masonk06/robot-dog-assembly/CURRENT-PCB.md

# Current PCB for the 1 oz cost-reduction request

Use **revision_one_oz**, revision C. Its native project is
`revision_one_oz/Luca_power_distribution_four_leg.kicad_pro`.

Its updated order package uses **1 oz copper on both sides** and **top-side-only
component placement**. The circuit and 5 A leg fuses are retained, with relocated
parts and new routing. Do not reuse revision B's Gerbers, BOM/CPL or assembly
drawings when requesting 1 oz. Re-upload the complete revision C set at JLCPCB.

Revision B remains preserved in `revision_four_leg` and requires 2 oz copper.
Both revisions are validation prototypes, with powered-use verification open.
