masonk06/robot-dog-assembly/reports/sim2real/20261026-212718.csv

time_s | servo_id | target_ticks | measured_ticks | error_ticks | temperature_c
0.0 | 8 | 1677 | 1677 | 0 | 31
0.0 | 9 | 1572 | 1577 | 5 | 32
0.0470000000022992 | 8 | 1677 | 1677 | 0 | 31
0.0470000000022992 | 9 | 1572 | 1576 | 4 | 32
0.09400000000096043 | 8 | 1677 | 1677 | 0 | 31
0.09400000000096043 | 9 | 1572 | 1576 | 4 | 32
0.125 | 8 | 1677 | 1677 | 0 | 31
0.125 | 9 | 1572 | 1576 | 4 | 32
0.1720000000022992 | 8 | 1677 | 1677 | 0 | 31
0.1720000000022992 | 9 | 1572 | 1574 | 2 | 32
0.20300000000133878 | 8 | 1677 | 1677 | 0 | 31
0.20300000000133878 | 9 | 1572 | 1574 | 2 | 32
0.2649999999994179 | 8 | 1677 | 1677 | 0 | 31
0.2649999999994179 | 9 | 1572 | 1574 | 2 | 32
0.2970000000022992 | 8 | 1677 | 1677 | 0 | 31
0.2970000000022992 | 9 | 1572 | 1574 | 2 | 32
0.3280000000013388 | 8 | 1678 | 1677 | -1 | 31
0.3280000000013388 | 9 | 1572 | 1574 | 2 | 32
0.375 | 8 | 1678 | 1677 | -1 | 31
0.375 | 9 | 1572 | 1574 | 2 | 32
0.40600000000267755 | 8 | 1678 | 1677 | -1 | 31
0.40600000000267755 | 9 | 1572 | 1574 | 2 | 32
0.4530000000013388 | 8 | 1678 | 1677 | -1 | 31
0.4530000000013388 | 9 | 1572 | 1574 | 2 | 32
0.48400000000037835 | 8 | 1678 | 1677 | -1 | 31
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
