masonk06/robot-dog-assembly/reports/sim2real/20261026-213629.csv

time_s | servo_id | target_ticks | measured_ticks | error_ticks | temperature_c
0.0 | 8 | 1677 | 1678 | 1 | 31
0.0 | 9 | 1572 | 1572 | 0 | 32
0.0790000000015425 | 8 | 1677 | 1678 | 1 | 31
0.0790000000015425 | 9 | 1572 | 1572 | 0 | 32
0.125 | 8 | 1677 | 1678 | 1 | 31
0.125 | 9 | 1572 | 1572 | 0 | 32
0.18800000000192085 | 8 | 1677 | 1678 | 1 | 31
0.18800000000192085 | 9 | 1572 | 1572 | 0 | 32
0.25 | 8 | 1677 | 1678 | 1 | 31
0.25 | 9 | 1572 | 1572 | 0 | 31
0.31300000000192085 | 8 | 1677 | 1678 | 1 | 31
0.31300000000192085 | 9 | 1572 | 1572 | 0 | 32
0.375 | 8 | 1678 | 1678 | 0 | 31
0.375 | 9 | 1572 | 1572 | 0 | 32
0.4220000000022992 | 8 | 1678 | 1678 | 0 | 31
0.4220000000022992 | 9 | 1572 | 1572 | 0 | 32
0.4850000000005821 | 8 | 1678 | 1678 | 0 | 31
0.4850000000005821 | 9 | 1572 | 1572 | 0 | 32
0.5470000000022992 | 8 | 1678 | 1678 | 0 | 31
0.5630000000019209 | 9 | 1572 | 1572 | 0 | 31
0.5940000000009604 | 8 | 1678 | 1678 | 0 | 31
0.5940000000009604 | 9 | 1573 | 1572 | -1 | 32
0.6880000000019209 | 8 | 1679 | 1678 | -1 | 31
0.6880000000019209 | 9 | 1573 | 1572 | -1 | 32
0.7350000000005821 | 8 | 1679 | 1678 | -1 | 31
0.7350000000005821 | 9 | 1573 | 1572 | -1 | 32
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
