masonk06/robot-dog-assembly/reports/sim2real/20261026-220232.csv

time_s | servo_id | target_ticks | measured_ticks | error_ticks | temperature_c
0.0 | 8 | 1677 | 1680 | 3 | 32
0.0 | 9 | 1572 | 1573 | 1 | 32
0.046999999998661224 | 8 | 1677 | 1680 | 3 | 32
0.046999999998661224 | 9 | 1572 | 1573 | 1 | 32
0.10899999999674037 | 8 | 1677 | 1680 | 3 | 32
0.10899999999674037 | 9 | 1572 | 1573 | 1 | 32
0.13999999999941792 | 8 | 1677 | 1680 | 3 | 32
0.1559999999954016 | 9 | 1572 | 1573 | 1 | 32
0.18699999999807915 | 8 | 1677 | 1680 | 3 | 32
0.18699999999807915 | 9 | 1572 | 1573 | 1 | 32
0.2649999999994179 | 8 | 1677 | 1680 | 3 | 32
0.2649999999994179 | 9 | 1572 | 1573 | 1 | 32
0.2969999999986612 | 8 | 1677 | 1680 | 3 | 32
0.2969999999986612 | 9 | 1572 | 1573 | 1 | 32
0.35899999999674037 | 8 | 1677 | 1680 | 3 | 32
0.35899999999674037 | 9 | 1572 | 1573 | 1 | 32
0.4059999999954016 | 8 | 1677 | 1680 | 3 | 32
0.4059999999954016 | 9 | 1572 | 1573 | 1 | 32
0.4530000000013388 | 8 | 1678 | 1680 | 2 | 32
0.4530000000013388 | 9 | 1572 | 1573 | 1 | 32
0.5 | 8 | 1678 | 1680 | 2 | 32
0.5 | 9 | 1572 | 1573 | 1 | 32
0.5469999999986612 | 8 | 1678 | 1680 | 2 | 32
0.5469999999986612 | 9 | 1572 | 1573 | 1 | 32
0.6089999999967404 | 8 | 1678 | 1680 | 2 | 32
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
