masonk06/robot-dog-assembly/hardware/replay_plans/rear-left-3deg/rear-left-small-preview.csv

time_s | hip_model_deg | knee_model_deg | hip_id8_ticks | knee_id9_ticks
0.000000000000000000e+00 | 0.000000000000000000e+00 | -0.000000000000000000e+00 | 1.677000000000000000e+03 | 1.572000000000000000e+03
4.000000000000000083e-02 | 8.892123004210696503e-04 | -3.638273935078280459e-04 | 1.677000000000000000e+03 | 1.572000000000000000e+03
8.000000000000000167e-02 | 3.496563621994713822e-03 | -1.430643310064679550e-03 | 1.677000000000000000e+03 | 1.572000000000000000e+03
1.199999999999999956e-01 | 7.731625595186588165e-03 | -3.163448353720606319e-03 | 1.677000000000000000e+03 | 1.572000000000000000e+03
1.600000000000000033e-01 | 1.350396985046234226e-02 | -5.525243128525658860e-03 | 1.677000000000000000e+03 | 1.572000000000000000e+03
2.000000000000000111e-01 | 2.072316801828763197e-02 | -8.479028238529888115e-03 | 1.677000000000000000e+03 | 1.572000000000000000e+03
2.399999999999999911e-01 | 2.929879172912812357e-02 | -1.198780428778335218e-02 | 1.677000000000000000e+03 | 1.572000000000000000e+03
2.800000000000000266e-01 | 3.914041261344945039e-02 | -1.601457188033609050e-02 | 1.677000000000000000e+03 | 1.572000000000000000e+03
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
