masonk06/robot-dog-assembly/hardware/replay_plans/rear-left-5deg/rear-left-small-preview.csv

time_s | hip_model_deg | knee_model_deg | hip_id8_ticks | knee_id9_ticks
0.000000000000000000e+00 | 0.000000000000000000e+00 | -0.000000000000000000e+00 | 1.677000000000000000e+03 | 1.572000000000000000e+03
5.999999999999999778e-02 | 1.482020281938936732e-03 | -6.063784124675527078e-04 | 1.677000000000000000e+03 | 1.572000000000000000e+03
1.199999999999999956e-01 | 5.827605176437851767e-03 | -2.384403249024952785e-03 | 1.677000000000000000e+03 | 1.572000000000000000e+03
1.799999999999999933e-01 | 1.288604075651990713e-02 | -5.272408908404313706e-03 | 1.677000000000000000e+03 | 1.572000000000000000e+03
2.399999999999999911e-01 | 2.250661309520825618e-02 | -9.208729789337748509e-03 | 1.677000000000000000e+03 | 1.572000000000000000e+03
2.999999999999999889e-01 | 3.453860826552605789e-02 | -1.413170029055736861e-02 | 1.677000000000000000e+03 | 1.572000000000000000e+03
3.599999999999999867e-01 | 4.883131234049649383e-02 | -1.997965481079529843e-02 | 1.678000000000000000e+03 | 1.572000000000000000e+03
4.199999999999999845e-01 | 6.523401139314267960e-02 | -2.669092774878363203e-02 | 1.678000000000000000e+03 | 1.572000000000000000e+03
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
