masonk06/robot-dog-assembly/hardware/replay_plans/rear-left-full-46s/rear-left-small-preview.csv

time_s | hip_model_deg | knee_model_deg | hip_id8_ticks | knee_id9_ticks
0.000000000000000000e+00 | 0.000000000000000000e+00 | -0.000000000000000000e+00 | 1.677000000000000000e+03 | 1.572000000000000000e+03
4.999999999999999584e-02 | 2.653465253920772246e-03 | -1.085681972209229153e-03 | 1.677000000000000000e+03 | 1.572000000000000000e+03
9.999999999999999167e-02 | 5.306930507841544492e-03 | -2.171363944418458307e-03 | 1.677000000000000000e+03 | 1.572000000000000000e+03
1.499999999999999944e-01 | 7.960395761762316738e-03 | -3.257045916627687460e-03 | 1.677000000000000000e+03 | 1.572000000000000000e+03
1.999999999999999833e-01 | 1.061386101568308898e-02 | -4.342727888836916614e-03 | 1.677000000000000000e+03 | 1.572000000000000000e+03
2.499999999999999722e-01 | 1.839436082802704472e-02 | -7.526168248026689211e-03 | 1.677000000000000000e+03 | 1.572000000000000000e+03
2.999999999999999889e-01 | 2.617486064037100740e-02 | -1.070960860721646354e-02 | 1.677000000000000000e+03 | 1.572000000000000000e+03
3.499999999999999778e-01 | 3.395536045271496661e-02 | -1.389304896640623788e-02 | 1.677000000000000000e+03 | 1.572000000000000000e+03
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
