masonk06/robot-dog-assembly/boot_fit.png

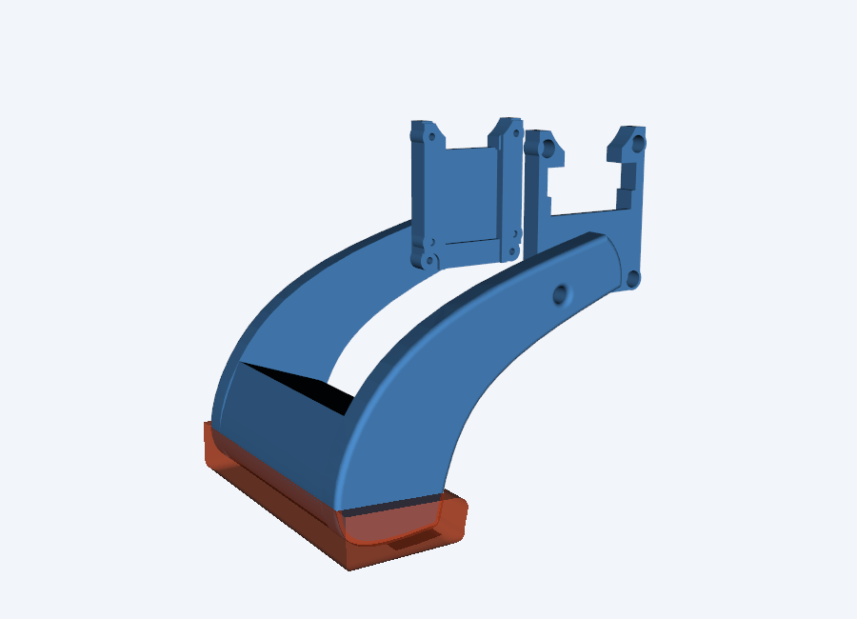
boot_fit.png
