masonk06/robot-dog-assembly/cad/frame_v7/Frame_V7_layout.png

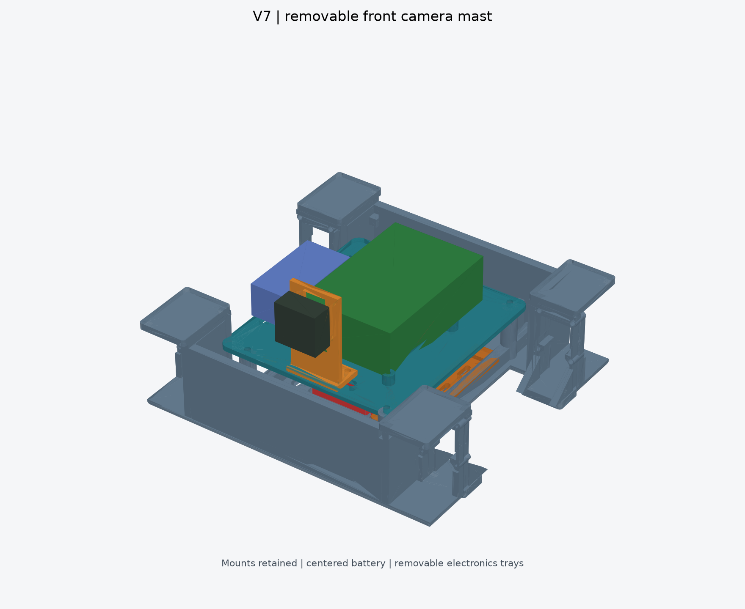
cad/frame_v7/Frame_V7_layout.png
