masonk06/robot-dog-assembly/cad/front_rear_leg_variants/Front_Leg_Orientation_Reference.png

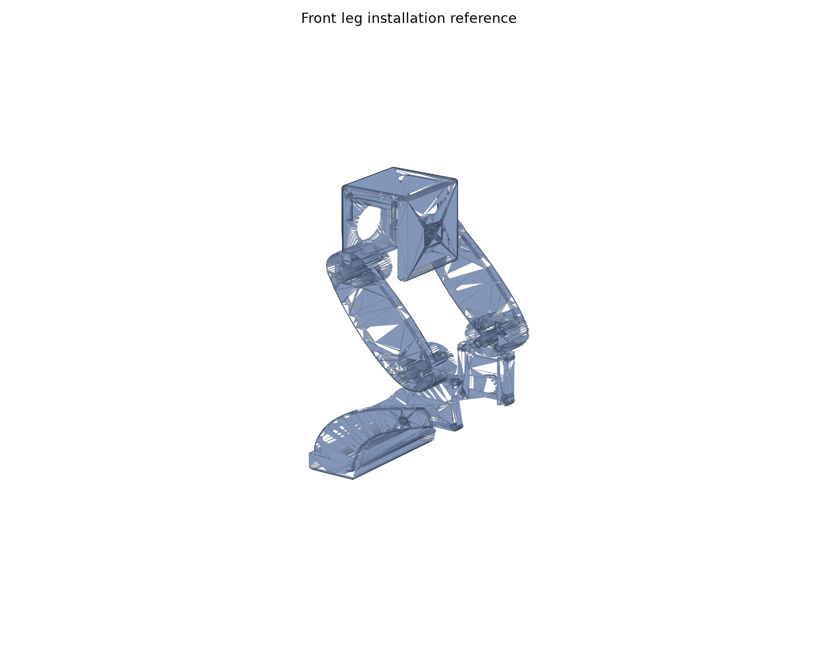
cad/front_rear_leg_variants/Front_Leg_Orientation_Reference.png
