masonk06/robot-dog-assembly/detail.png

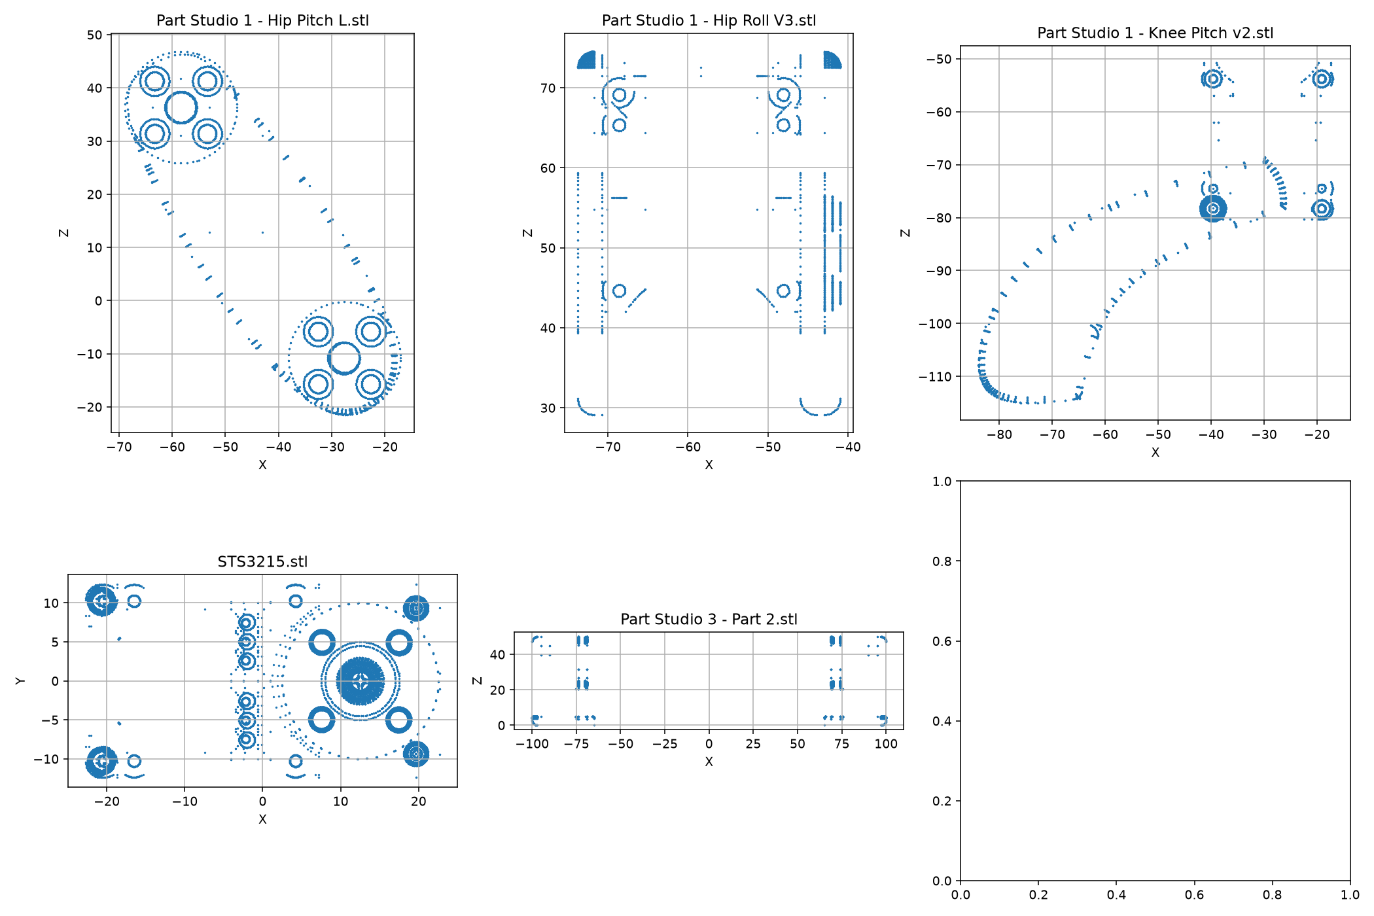
detail.png
