masonk06/robot-dog-assembly/reports/sim2real/simulation-neutral-reference.png

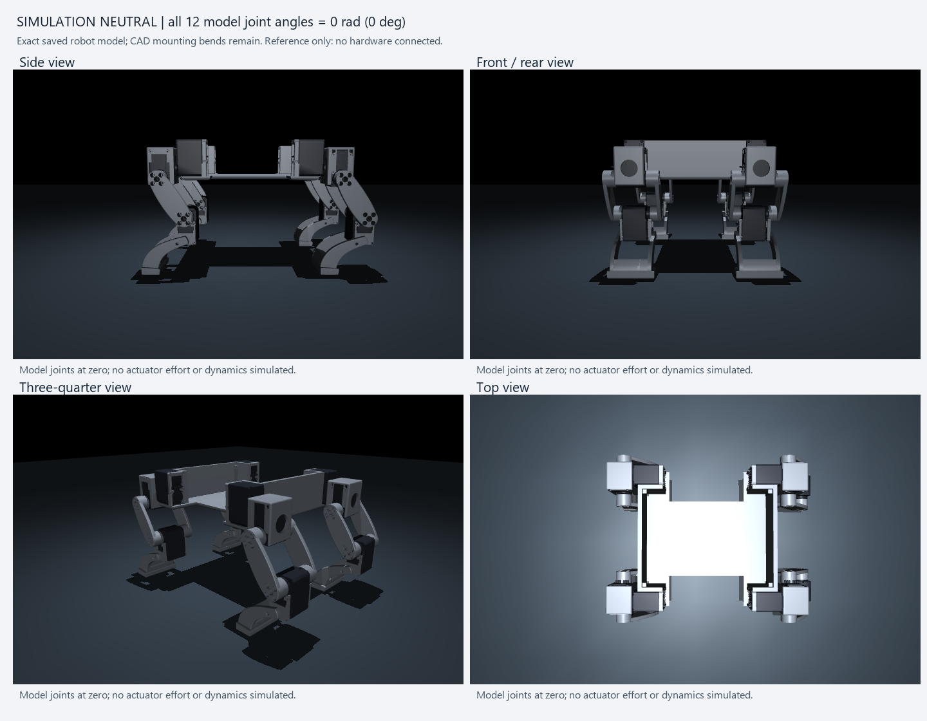
reports/sim2real/simulation-neutral-reference.png
