masonk06/robot-dog-assembly/revision_four_leg/layout-preview.png

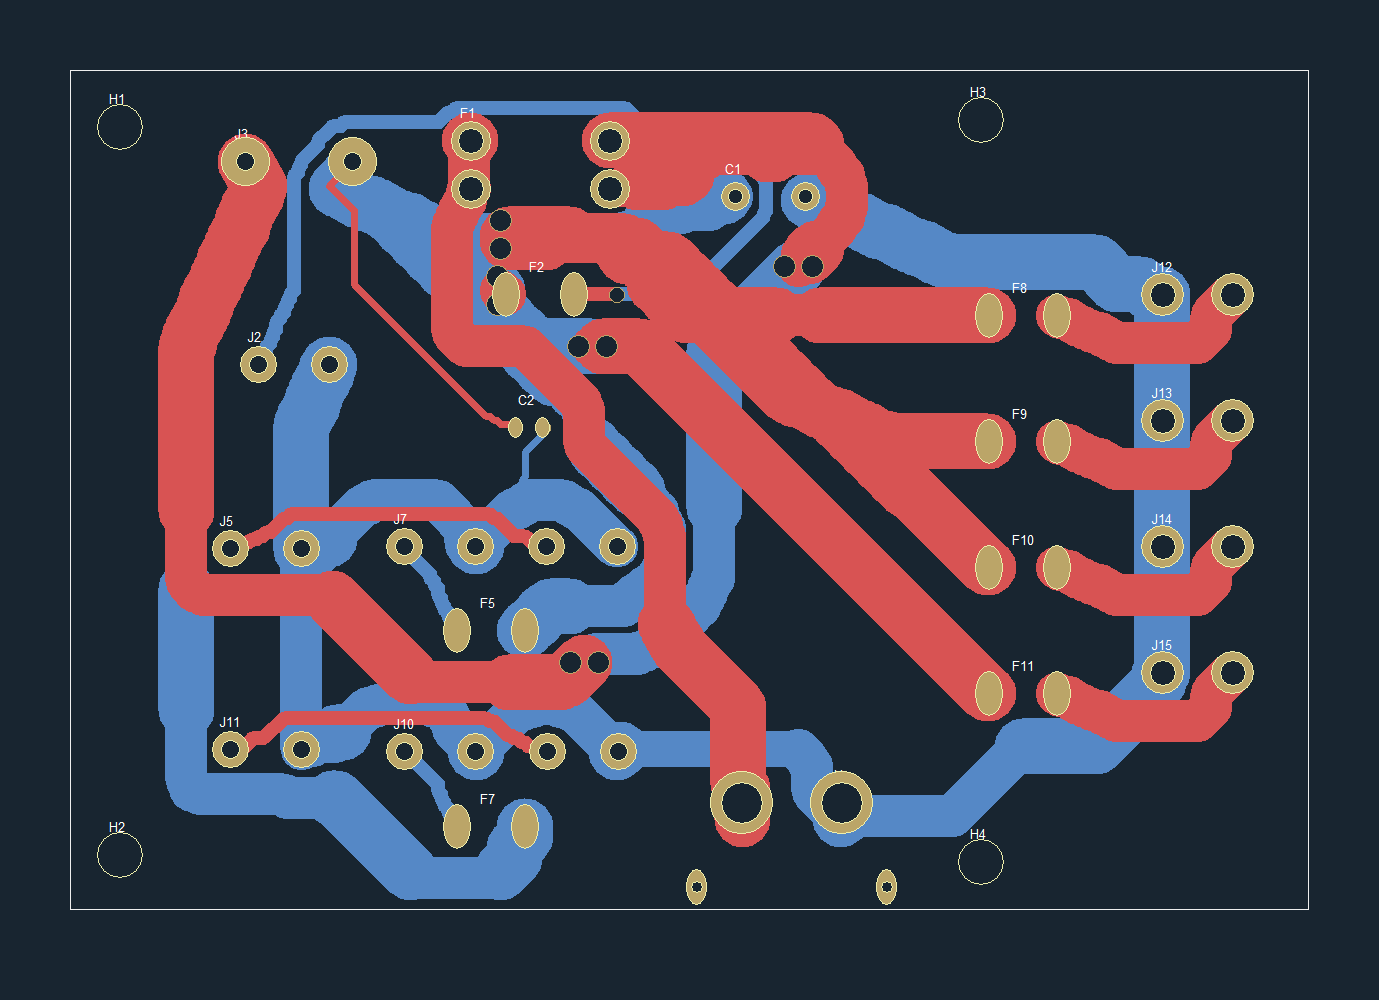
revision_four_leg/layout-preview.png
