masonk06/robot-dog-assembly/revision_four_leg/manufacturer_references/Bel_0680H_mechanical.png

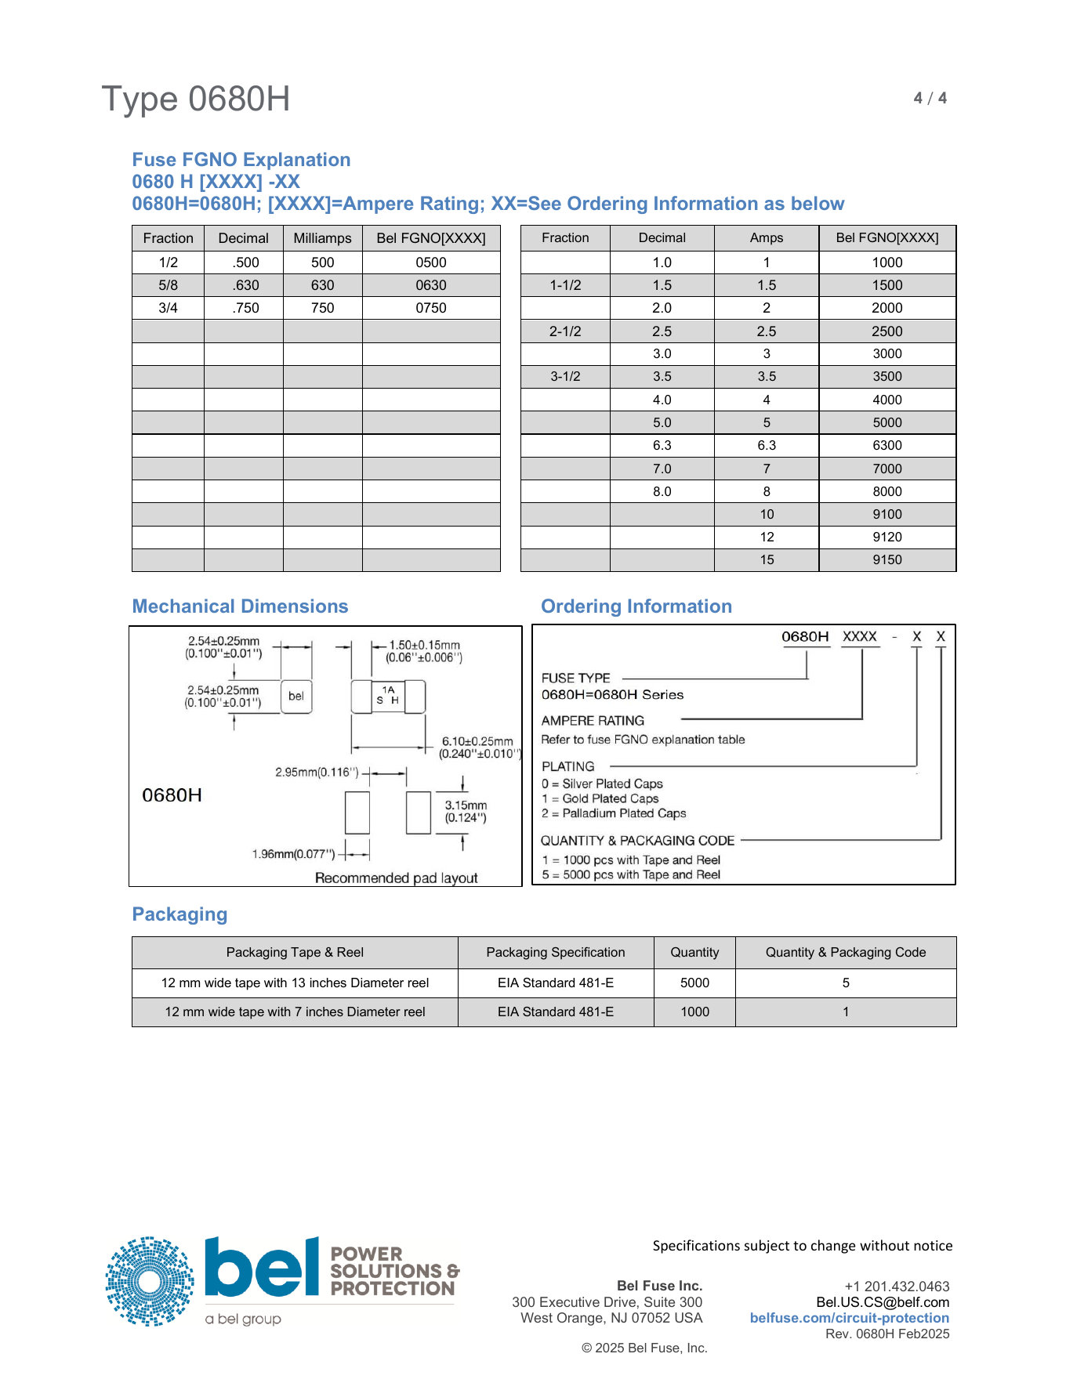
revision_four_leg/manufacturer_references/Bel_0680H_mechanical.png
