masonk06/robot-dog-assembly/revision_one_oz/COPPER-FINAL-1.png

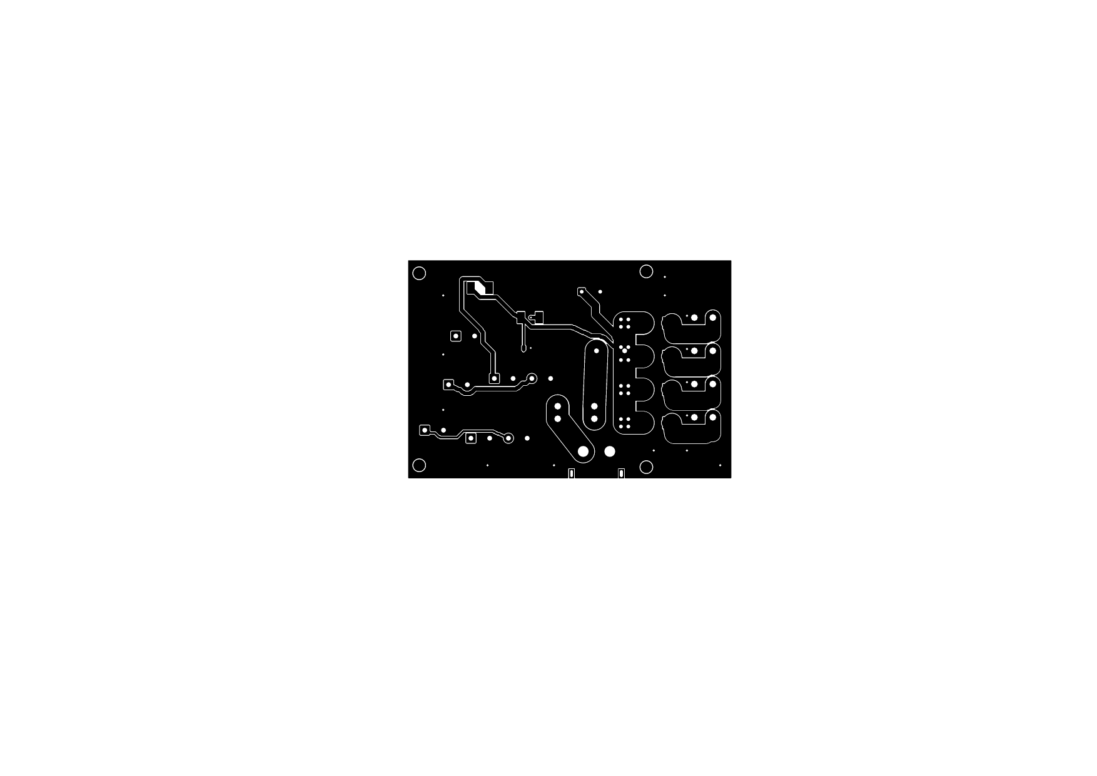
revision_one_oz/COPPER-FINAL-1.png
