masonk06/robot-dog-assembly/roll_detail.png

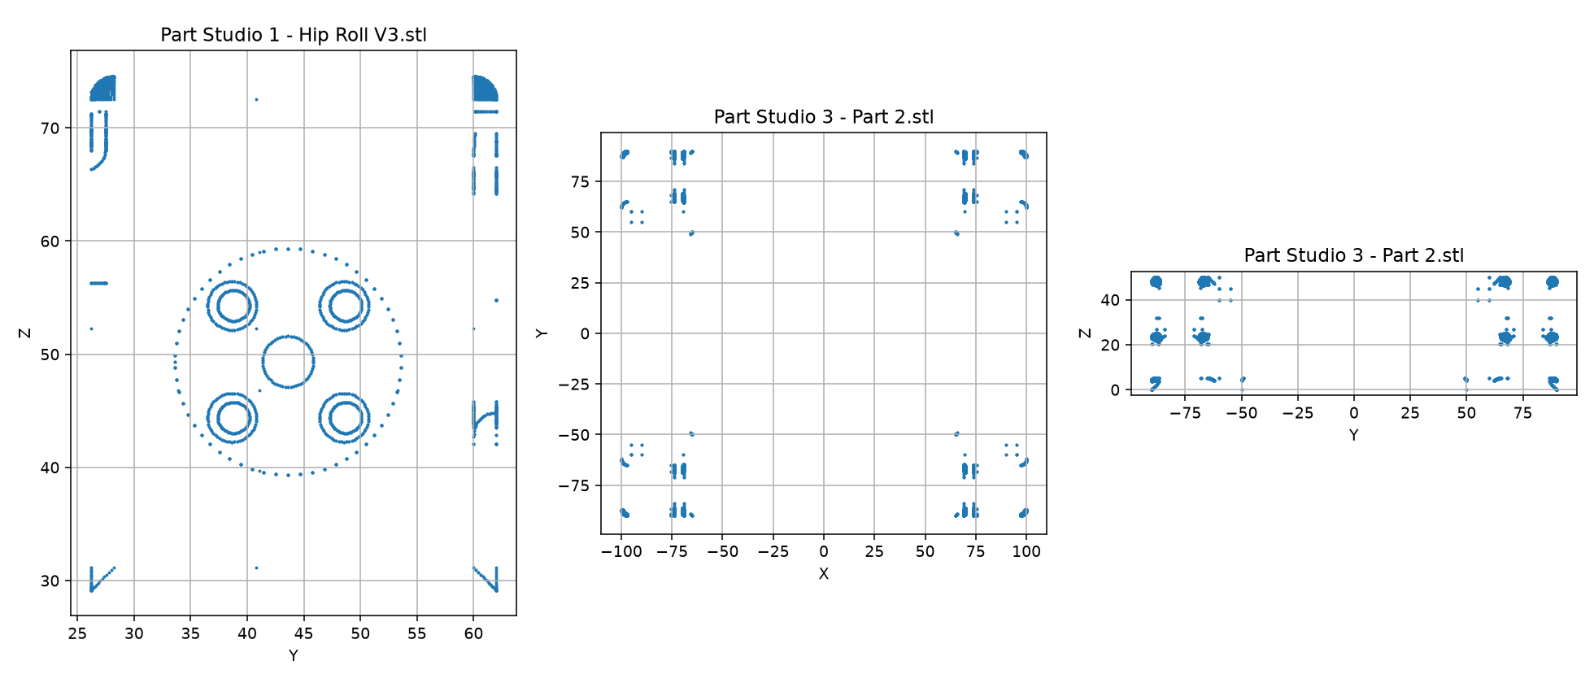
roll_detail.png
