masonk06/robot-dog-assembly/runs/com-dynamics-study/comparison.png

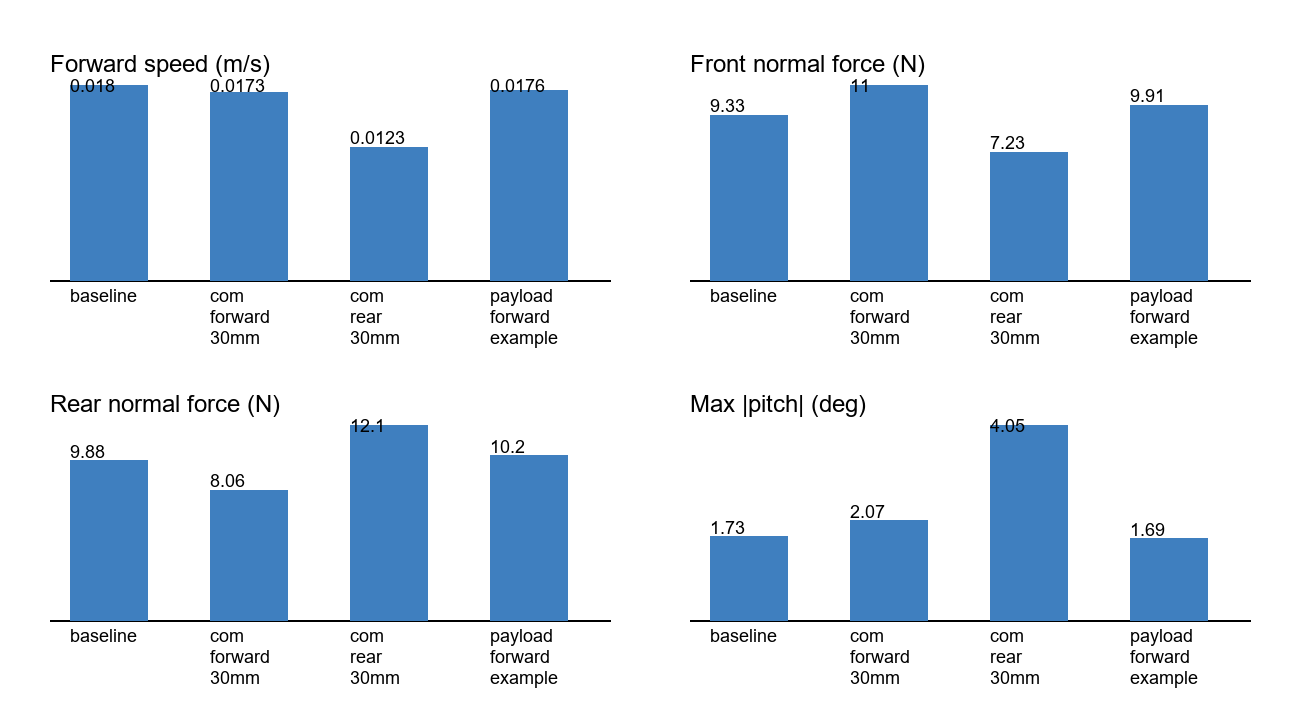
runs/com-dynamics-study/comparison.png
