masonk06/robot-dog-assembly/cad/parts.png

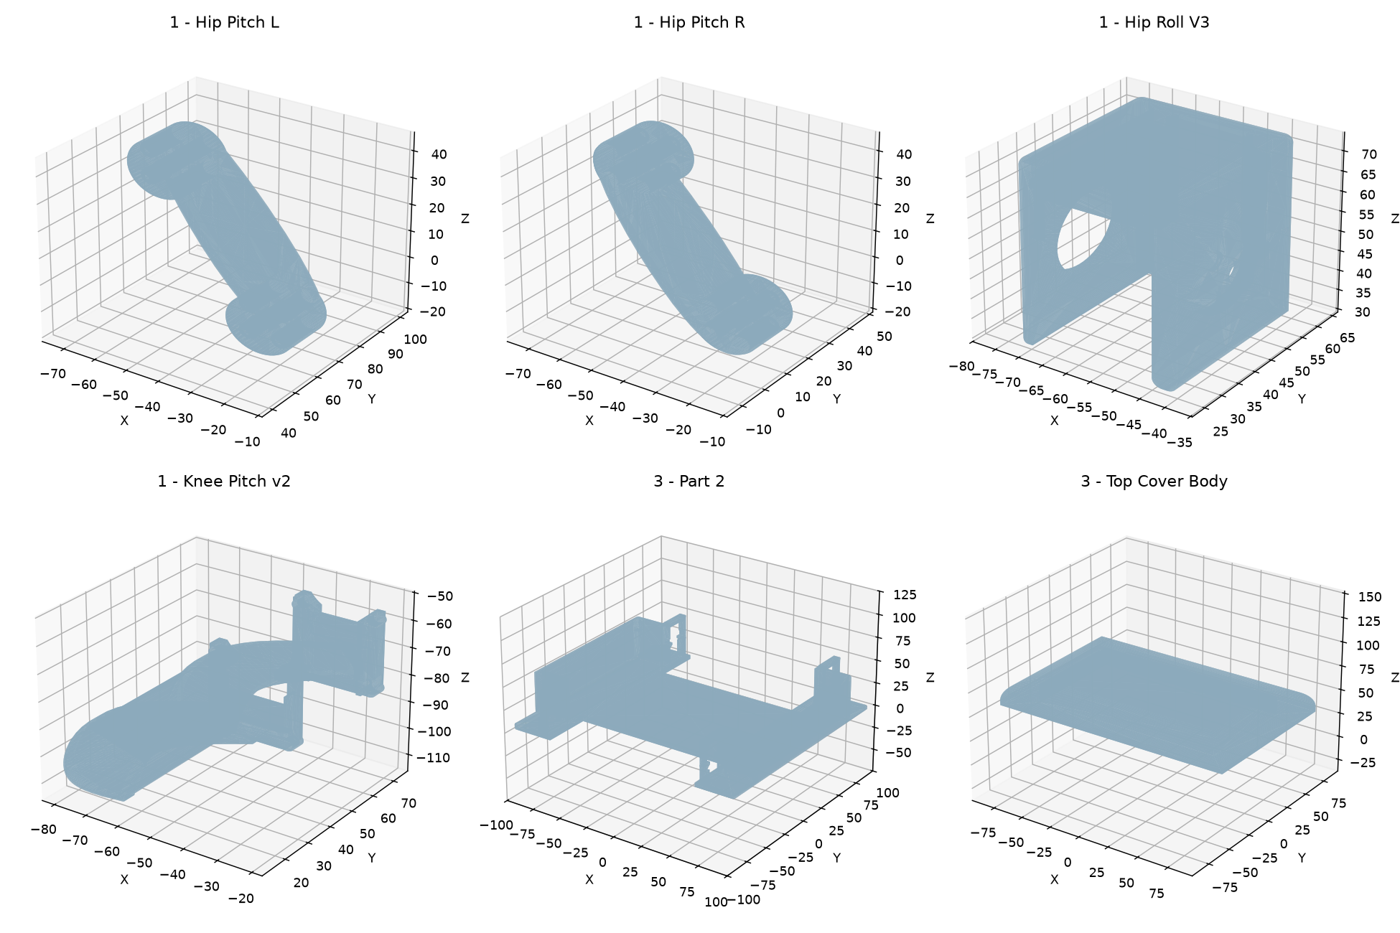
cad/parts.png
