masonk06/robot-dog-assembly/cad/frame_v7/RoboDog_V7_Equipment_Layout.step

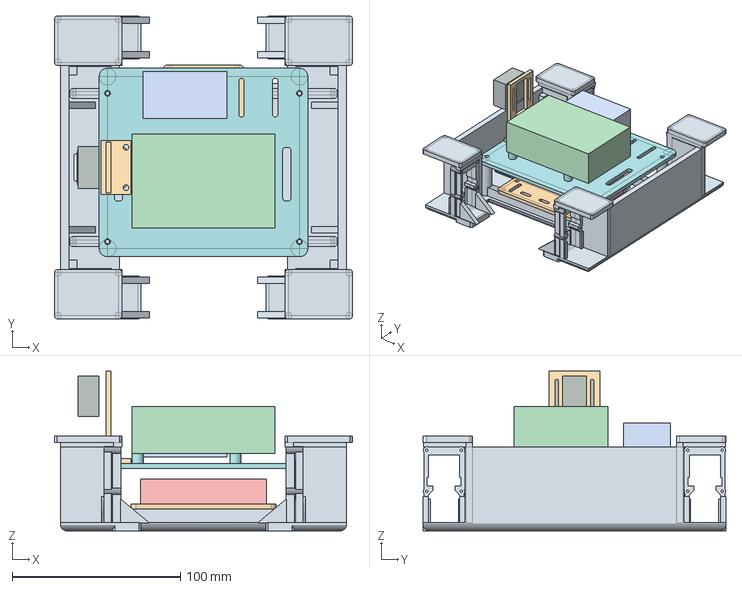
[picture p15: CAD file, 2026-11-04]
cad/frame_v7/RoboDog_V7_Equipment_Layout.step
177.0 x 179.8 x 95.0 mm
