masonk06/robot-dog-assembly/cad/front_rear_leg_variants/Front_Leg_Orientation_Reference.step

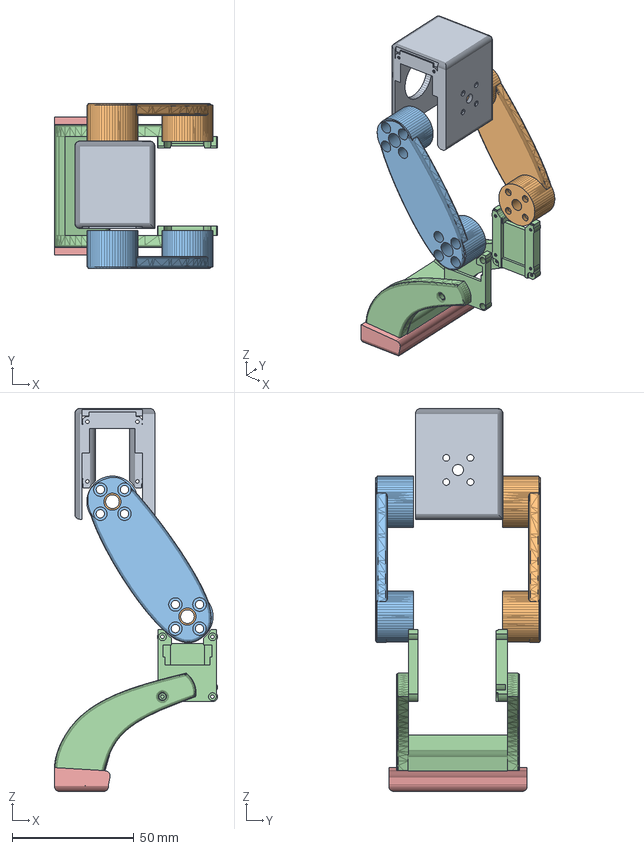
[picture p16: CAD file, 2026-10-26]
cad/front_rear_leg_variants/Front_Leg_Orientation_Reference.step
66.9 x 67.6 x 157.0 mm
