masonk06/robot-dog-assembly/cad/positioned_parts/rear_left_hip_roll.stl

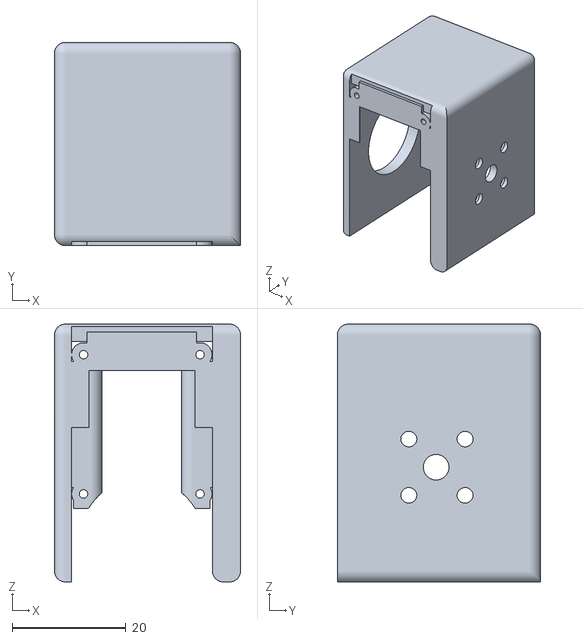
[picture p17: CAD file, 2026-10-26]
cad/positioned_parts/rear_left_hip_roll.stl
32.8 x 35.8 x 45.4
