masonk06/robot-dog-assembly/cad/revision_sources/STS3215_case_fixed.step

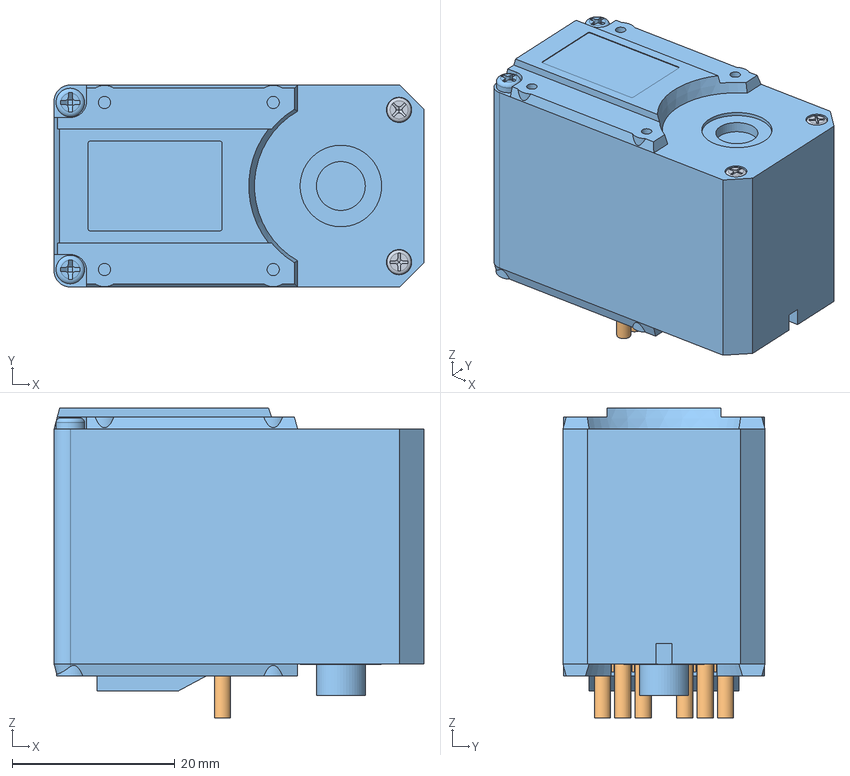
[picture p18: CAD file, 2026-10-26]
cad/revision_sources/STS3215_case_fixed.step
45.4 x 24.8 x 38.0 mm
