masonk06/robot-dog-assembly/cad/robot_dog_layout.stl

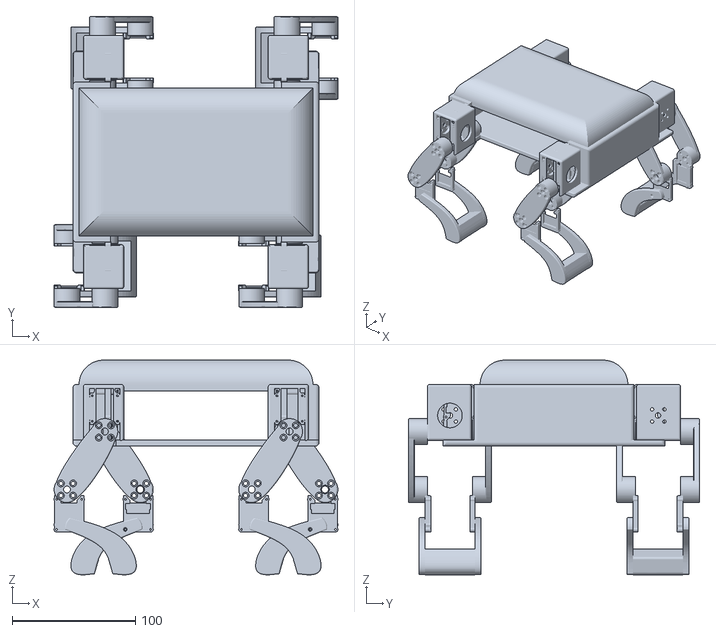
[picture p19: CAD file, 2026-10-26]
cad/robot_dog_layout.stl
230.6 x 236.6 x 174.4
