masonk06/robot-dog-assembly/cad/solid_sources/Part Studio 1 - Hip Pitch L.step

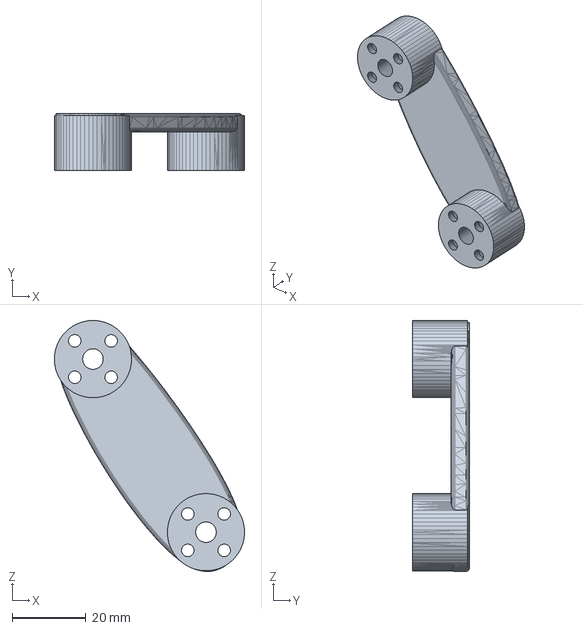
[picture p20: CAD file, 2026-10-26]
cad/solid_sources/Part Studio 1 - Hip Pitch L.step
51.7 x 15.5 x 68.3 mm
