masonk06/robot-dog-assembly/cad/source/STS3215.stl

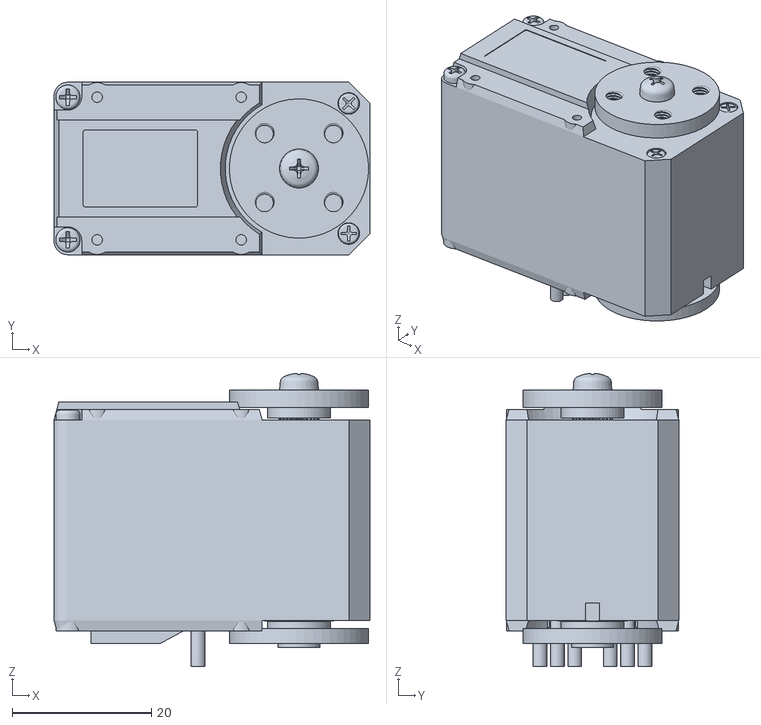
[picture p21: CAD file, 2026-10-26]
cad/source/STS3215.stl
45.4 x 24.8 x 42.1
