masonk06/robot-dog-assembly/revision_sources/boots.stl

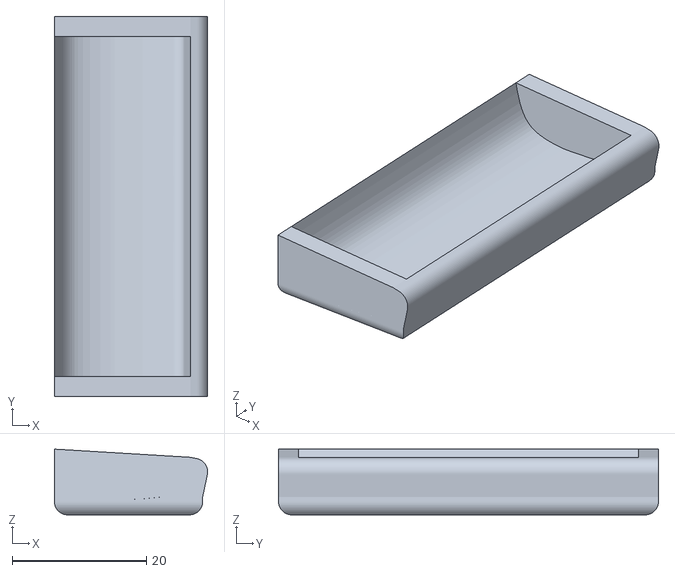
[picture p22: CAD file, 2026-10-24]
revision_sources/boots.stl
22.8 x 56.6 x 9.80
