masonk06/robot-dog-assembly/source/Part Studio 3 - Top Cover Body.stl

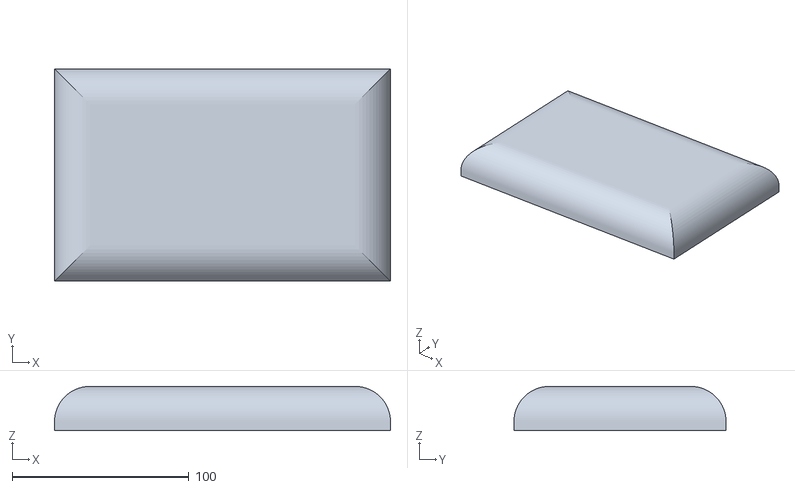
[picture p23: CAD file, 2026-10-24]
source/Part Studio 3 - Top Cover Body.stl
190.0 x 120.0 x 25.0
