masonk06/robot-dog-assembly/cad/revision_sources/FRAME V2.stl

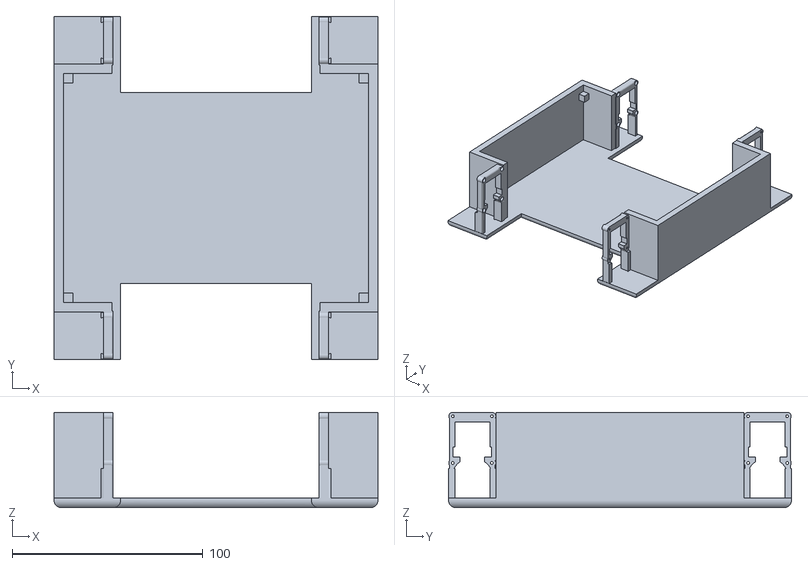
[picture p24: CAD file, 2026-10-26]
cad/revision_sources/FRAME V2.stl
170.0 x 180.0 x 50.1
