masonk06/robot-dog-assembly/positioned_parts/front_right_knee_v2.stl

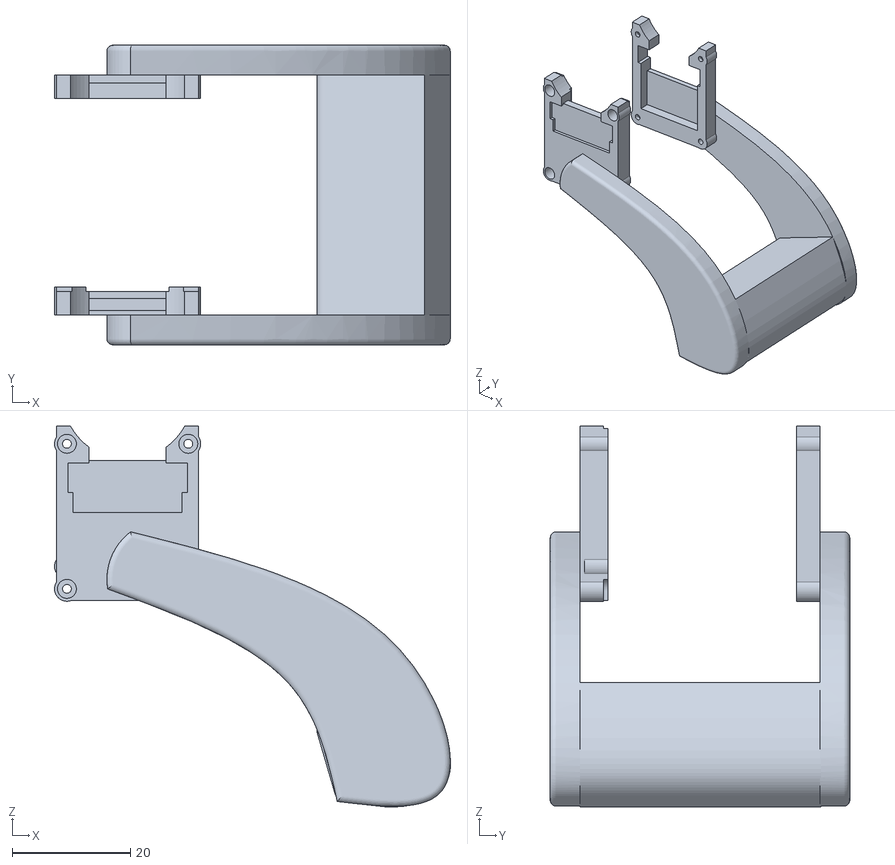
[picture p25: CAD file, 2026-10-24]
positioned_parts/front_right_knee_v2.stl
66.9 x 50.6 x 64.3
