masonk06/robot-dog-assembly/source/Part Studio 3 - Part 2.stl

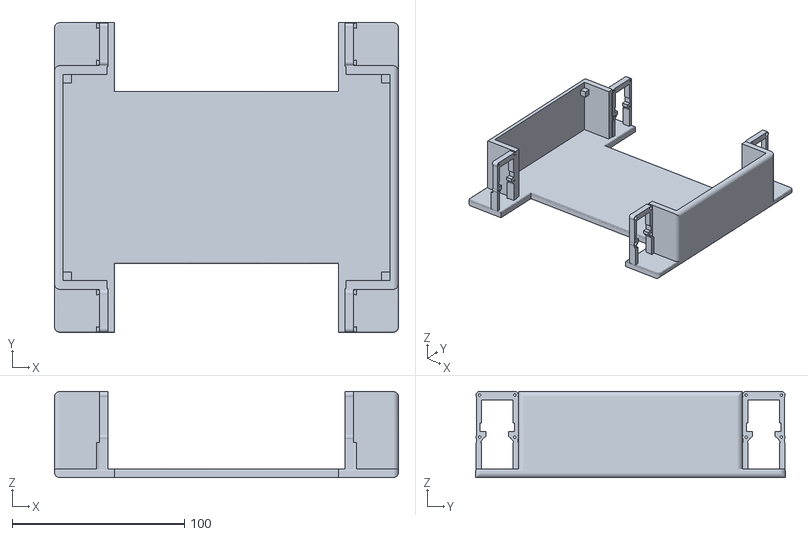
[picture p26: CAD file, 2026-10-24]
source/Part Studio 3 - Part 2.stl
200.0 x 180.0 x 50.1
