masonk06/robot-dog-assembly/cad/frame_v7/Camera_Mast.step

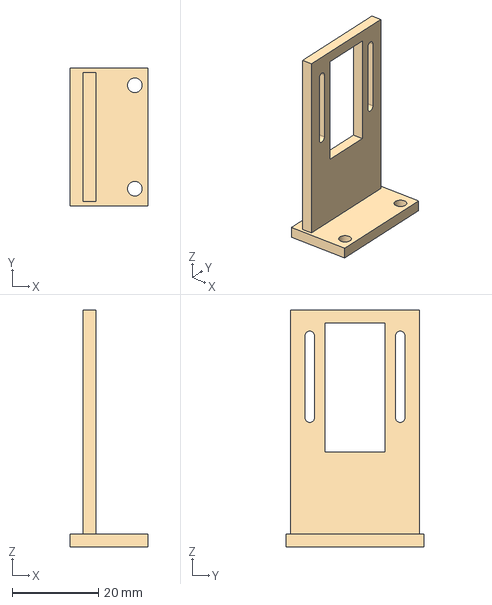
[picture p27: CAD file, 2026-11-04]
cad/frame_v7/Camera_Mast.step
18.0 x 32.0 x 55.0 mm
