masonk06/robot-dog-assembly/cad/frame_v7/Power_Distribution_Sled.step

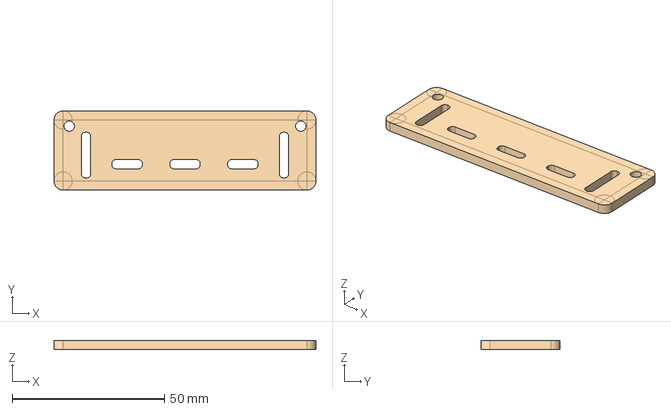
[picture p28: CAD file, 2026-11-04]
cad/frame_v7/Power_Distribution_Sled.step
86.0 x 26.0 x 3.00 mm
