masonk06/robot-dog-assembly/revision_sources/STS3215_discs_output.step

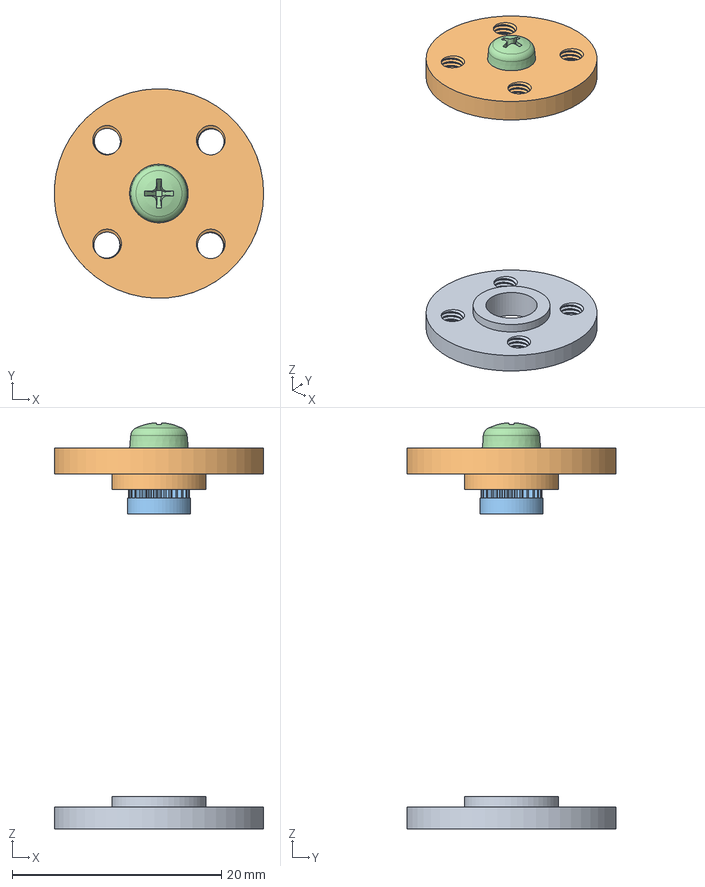
[picture p29: CAD file, 2026-10-24]
revision_sources/STS3215_discs_output.step
20.0 x 20.0 x 38.8 mm
