masonk06/robot-dog-assembly/cad/frame_v7/Pi5_Electronics_Deck.step

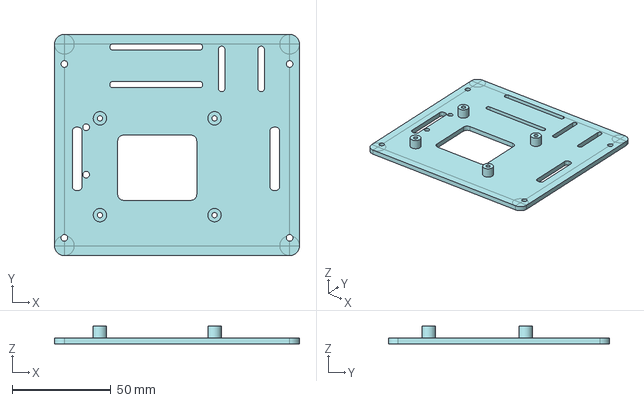
[picture p30: CAD file, 2026-11-04]
cad/frame_v7/Pi5_Electronics_Deck.step
124.0 x 112.0 x 9.00 mm
