masonk06/robot-dog-assembly/cad/frame_v7/Frame_V7.step

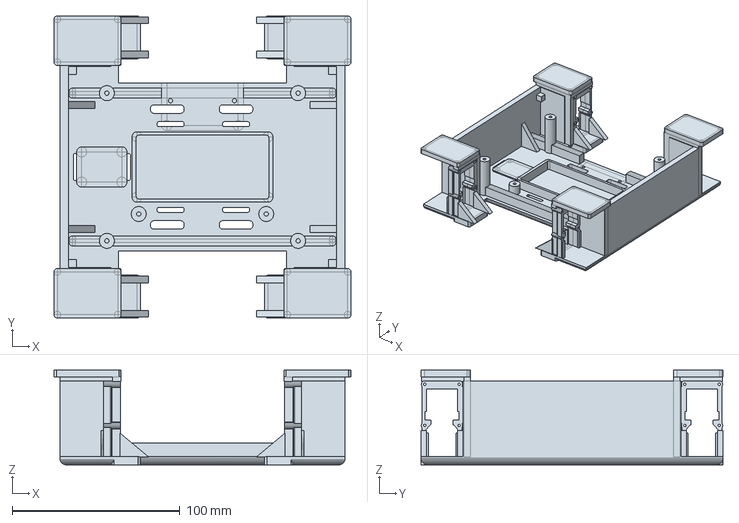
[picture p31: CAD file, 2026-11-04]
cad/frame_v7/Frame_V7.step
177.0 x 179.8 x 56.5 mm
