masonk06/robot-dog-assembly/cad/frame_v7/Waveshare_Sled.step

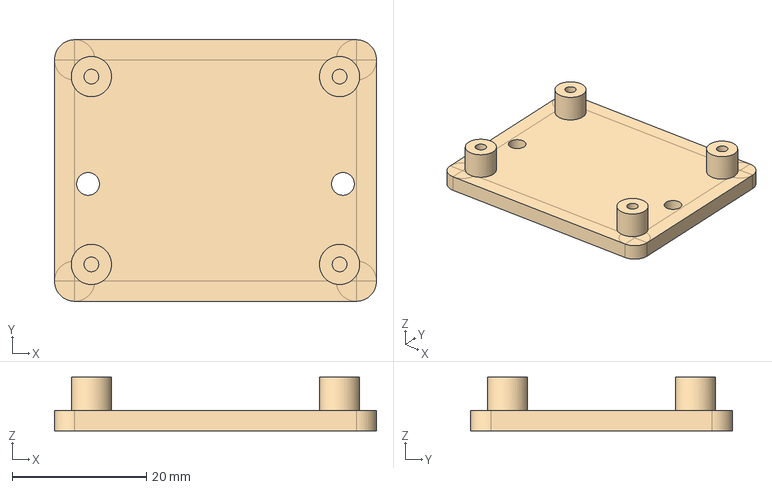
[picture p32: CAD file, 2026-11-04]
cad/frame_v7/Waveshare_Sled.step
48.0 x 39.0 x 8.00 mm
