masonk06/robot-dog-assembly/(list of files, cad)

Other CAD files:
front_rear_leg_variants/Rear_Leg_Orientation_Reference.step
mujoco_v2/assets/Part Studio 1 - Hip Pitch R.stl
positioned_parts/front_right_hip_roll.stl
solid_sources/Part Studio 1 - Hip Pitch R.step
cad/positioned_parts/rear_right_hip_pitch_R.stl
cad/solid_sources/boots.step
cad/source/Part Studio 1 - Hip Roll V3.stl
revision_sources/servo-motor_sts3215-v10.step
solid_sources/Part Studio 1 - Knee Pitch v2.step
cad/positioned_parts/rear_right_hip_pitch_L.stl
cad/revision_sources/Part Studio 1 - Knee Pitch v2.stl
positioned_parts/rear_right_hip_roll.stl
revision_sources/Part Studio 1 - Hip Pitch L.stl
solid_sources/FRAME V2.step
cad/positioned_parts/frame.stl
positioned_parts/rear_right_knee_v2.stl
solid_sources/Part Studio 1 - Hip Roll V3.step
cad/positioned_parts/front_left_hip_pitch_L.stl
positioned_parts/rear_left_hip_pitch_R.stl
cad/positioned_parts/rear_left_hip_pitch_L.stl
positioned_parts/front_left_hip_roll.stl
cad/positioned_parts/front_right_hip_pitch_L.stl
positioned_parts/front_left_hip_pitch_R.stl
cad/positioned_parts/front_left_knee_v2.stl
cad/positioned_parts/top_cover.stl
cad/positioned_parts/rear_left_knee_v2.stl
cad/positioned_parts/front_right_hip_pitch_R.stl
RoboDog.f3d
RoboDog_geometry_backup.f3d
cad/Recovered Fusion/RoboDog - FRAME V2 + boots.f3d
cad/RoboDog - Knee Housing Connections.f3d
cad/frame_v3/Frame_V3.step
cad/frame_v3/Frame_V3.stl
cad/frame_v3/Jetson_Tray.step
cad/frame_v3/Jetson_Tray.stl
cad/frame_v3/RoboDog_Frame_V3_Assembly.step
cad/frame_v3/RoboDog_Frame_V3_Layout_Reference.step
cad/frame_v3/Waveshare_Sled.step
cad/frame_v3/Waveshare_Sled.stl
cad/frame_v4/Frame_V4_Reinforced.step
cad/frame_v4/Frame_V4_Reinforced.stl
cad/frame_v4/RoboDog_Frame_V4_Assembly.step
cad/frame_v5/Frame_V5_Servo_Canopies.step
cad/frame_v5/Frame_V5_Servo_Canopies.stl
cad/frame_v5/RoboDog_Frame_V5_Assembly.step
cad/frame_v6/Frame_V6.step
cad/frame_v6/Frame_V6.stl
cad/frame_v6/Pi5_Electronics_Deck.step
cad/frame_v6/Pi5_Electronics_Deck.stl
cad/frame_v6/Power_Distribution_Sled.step
cad/frame_v6/Power_Distribution_Sled.stl
cad/frame_v6/Regulator_Spacer.step
cad/frame_v6/Regulator_Spacer.stl
cad/frame_v6/RoboDog_Frame_V6_Assembly.step
cad/frame_v6/RoboDog_Frame_V6_Packaging_Reference.step
cad/frame_v6/RoboDog_V6_Complete.step
cad/frame_v6/RoboDog_V6_Equipment_Layout.step
cad/frame_v6/Waveshare_Sled.step
cad/frame_v6/Waveshare_Sled.stl
cad/frame_v7/Camera_Mast.stl
cad/frame_v7/Frame_V7.stl
cad/frame_v7/Pi5_Electronics_Deck.stl
cad/frame_v7/Power_Distribution_Sled.stl
cad/front_rear_leg_variants/Front_Leg_Orientation_Reference.stl
cad/front_rear_leg_variants/Rear_Leg_Orientation_Reference.stl
cad/robot_dog_layout.obj
