masonk06/robot-dog-assembly/assembly_preview.png

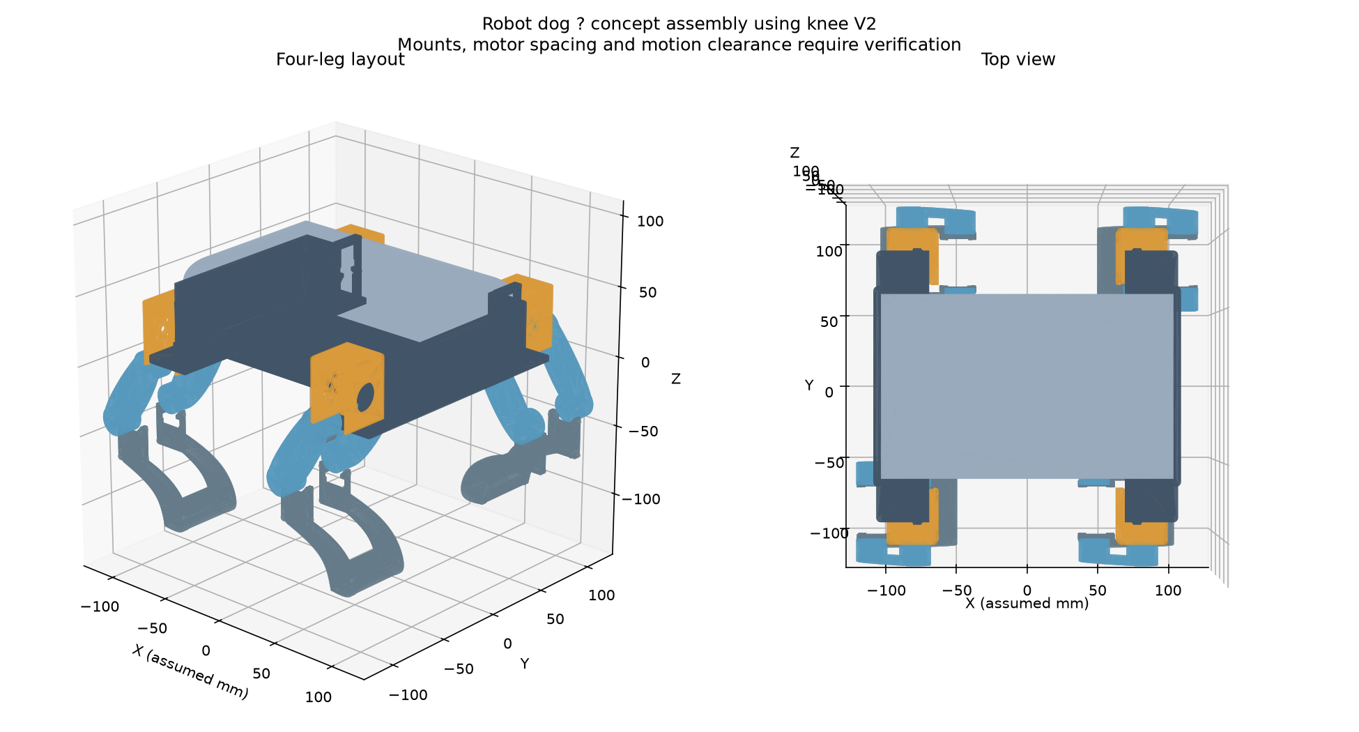
assembly_preview.png
