masonk06/robot-dog-assembly/manufacturing/layout-preview.png

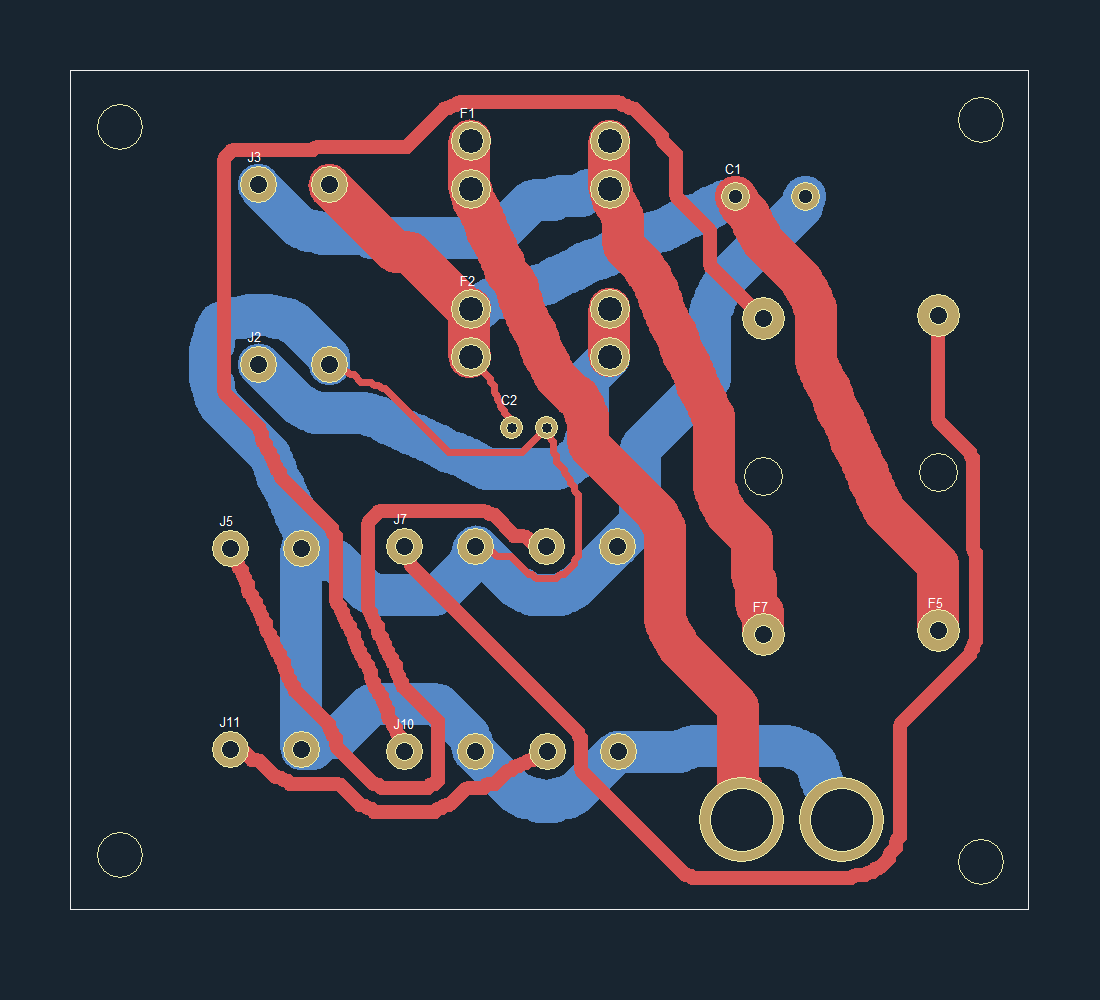
manufacturing/layout-preview.png
