masonk06/robot-dog-assembly/revision_four_leg/jlcpcb_pcba_revB/assembly/ASSEMBLY_BOTTOM.png

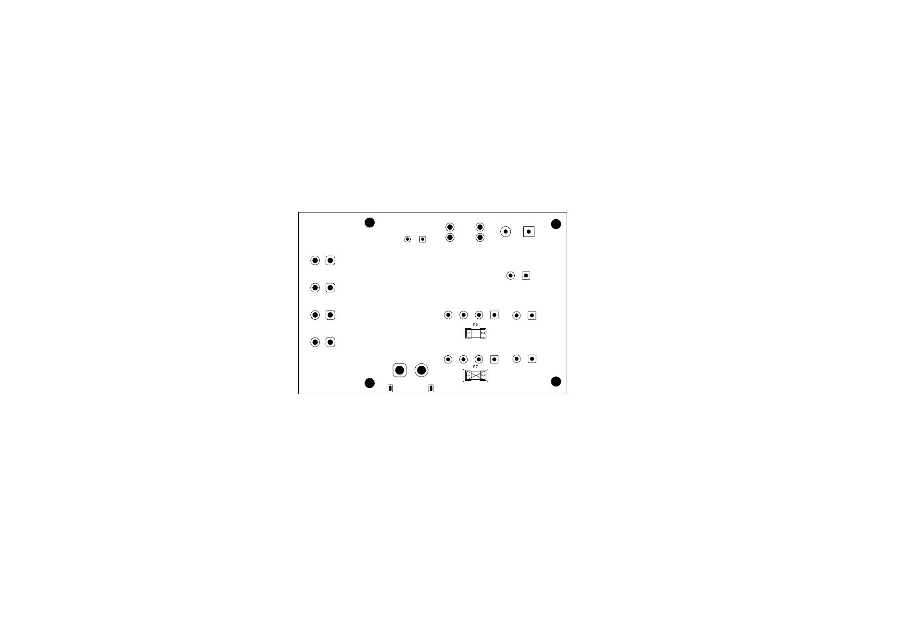
revision_four_leg/jlcpcb_pcba_revB/assembly/ASSEMBLY_BOTTOM.png
