masonk06/robot-dog-assembly/revision_four_leg/jlcpcb_pcba_revB/manufacturer_references/Phoenix_1868076_plan.jpg

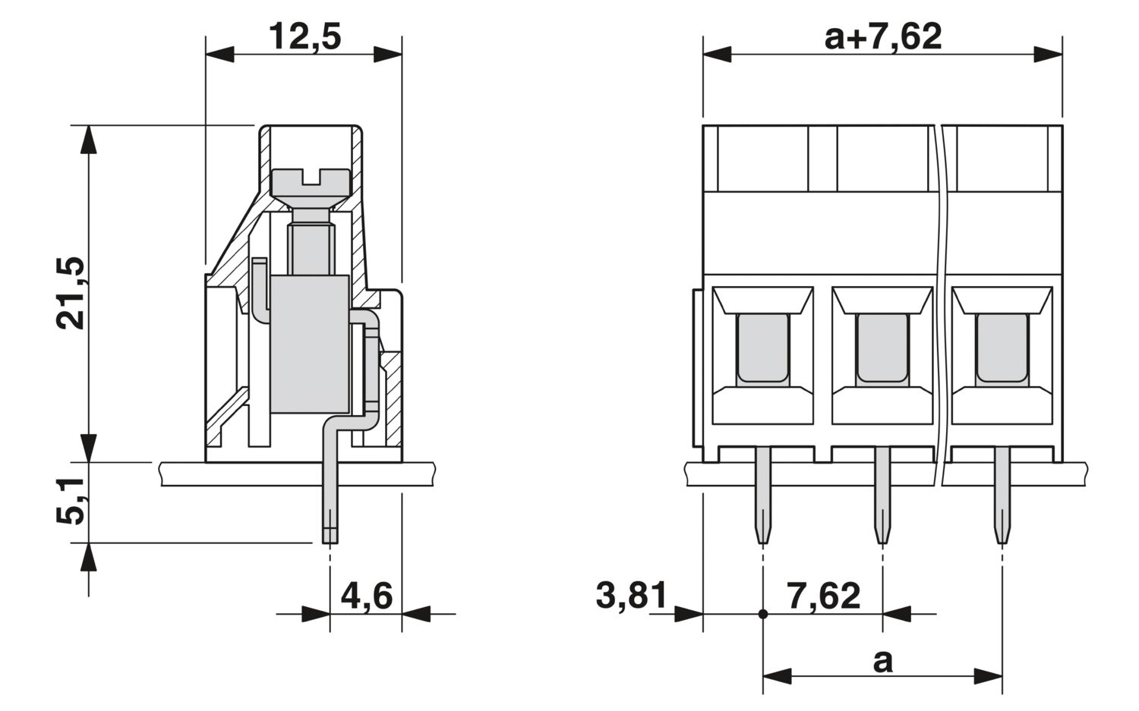
revision_four_leg/jlcpcb_pcba_revB/manufacturer_references/Phoenix_1868076_plan.jpg
