masonk06/robot-dog-assembly/revision_four_leg/manufacturer_references/AMASS_XT60PW-M.png

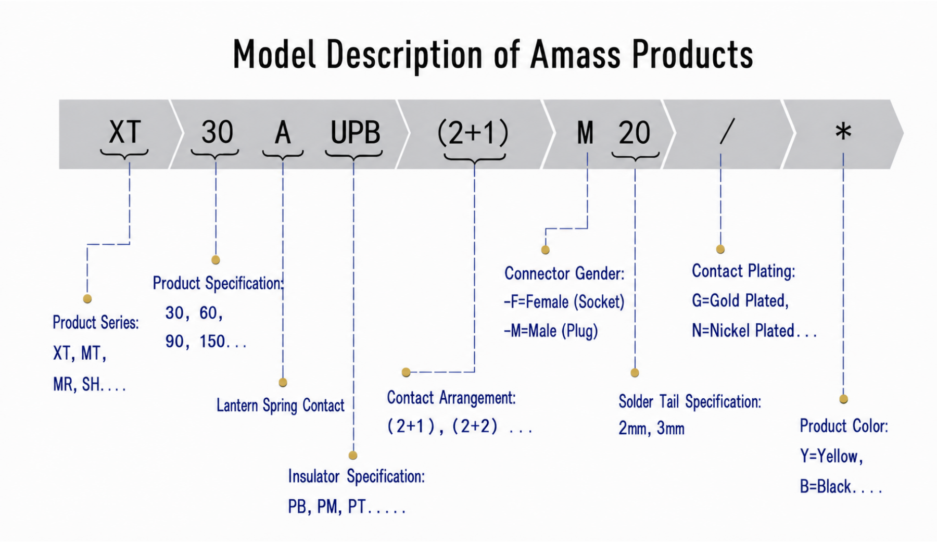
revision_four_leg/manufacturer_references/AMASS_XT60PW-M.png
