masonk06/robot-dog-assembly/revision_four_leg/manufacturer_references/Phoenix_1868076_dimensions.jpg

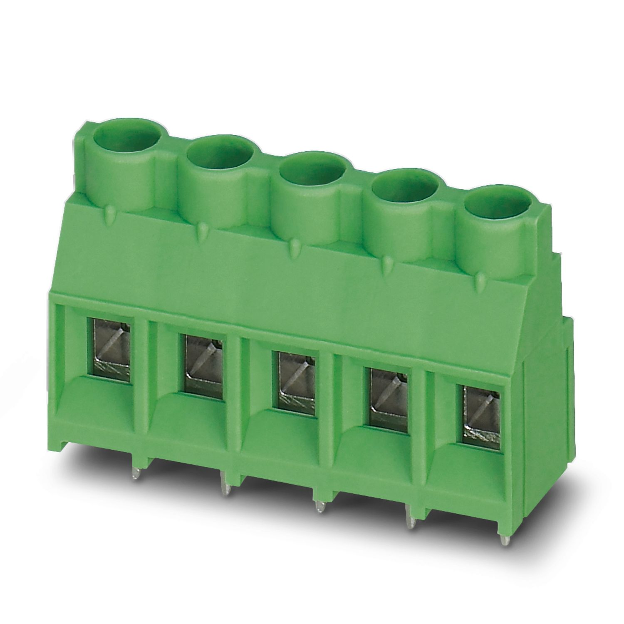
revision_four_leg/manufacturer_references/Phoenix_1868076_dimensions.jpg
