masonk06/robot-dog-assembly/revision_one_oz/jlcpcb_pcba_revC_1oz/assembly/ASSEMBLY_TOP.png

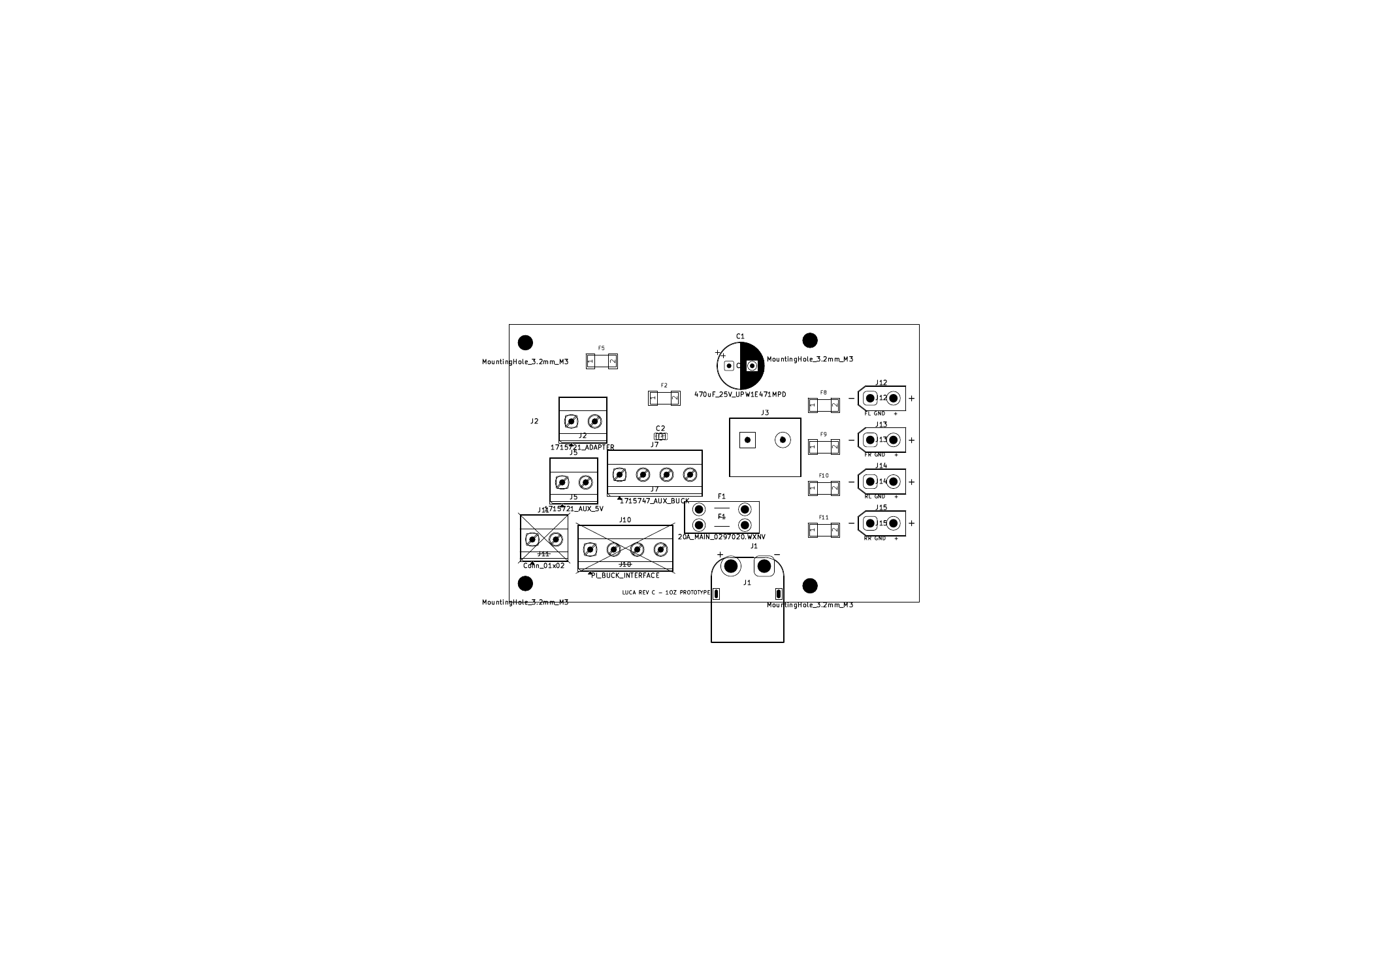
revision_one_oz/jlcpcb_pcba_revC_1oz/assembly/ASSEMBLY_TOP.png
