masonk06/robot-dog-assembly/mujoco_v2/robot_dog_v2.xml

<mujoco model="RoboDog V2 - conservative RL model">
  <compiler angle="radian" meshdir="assets" inertiafromgeom="false" />
  <option timestep=".002" integrator="implicitfast" gravity="0 0 -9.80665" />
  <default />
  <asset>
    <mesh name="mesh_0" file="FRAME V2.stl" scale=".001 .001 .001" />
    <mesh name="mesh_1" file="Part Studio 1 - Hip Roll V3.stl" scale=".001 .001 .001" />
    <mesh name="mesh_2" file="Part Studio 1 - Hip Pitch L.stl" scale=".001 .001 .001" />
    <mesh name="mesh_3" file="Part Studio 1 - Hip Pitch R.stl" scale=".001 .001 .001" />
    <mesh name="mesh_4" file="Part Studio 1 - Knee Pitch v2.stl" scale=".001 .001 .001" />
    <mesh name="mesh_5" file="boots.stl" scale=".001 .001 .001" />
    <mesh name="mesh_6" file="STS3215.stl" scale=".001 .001 .001" />
  </asset>
  <worldbody>
    <light pos="0 0 1" dir="0 0 -1" />
    <geom name="floor" type="plane" size="2 2 .05" rgba=".25 .3 .35 1" friction=".8 .01 .001" contype="1" conaffinity="2" />
    <body name="base" pos="0 0 .12">
      <freejoint />
      <inertial mass="1.282" pos="0 0 .025" diaginertia=".00415 .00496 .00774" />
      <geom name="body_contact_proxy" type="box" pos=".015 0 .025" size=".085 .09 .025" rgba="0 0 0 0" group="3" contype="2" conaffinity="1" />
      <geom name="frame" type="mesh" mesh="mesh_0" pos="0 0 0" quat="1 0 0 0" rgba=".62 .66 .72 1" contype="0" conaffinity="0" group="1" />
      <body name="front_left_roll_link" pos="-0.108576997 -0.0775 0.014">
        <joint name="front_left_hip_roll" type="hinge" axis="1 0 0" range="-.5 .5" damping=".025" armature=".00002" />
        <inertial mass=".066" pos="-0.017399993 0 -0.013000002" diaginertia=".0000176 .0000176 .0000176" />
        <geom name="front_left_hip_roll" type="mesh" mesh="mesh_1" pos="0.070961925 -0.0436 -0.048145677" quat="1 0 0 0" rgba=".62 .66 .72 1" contype="0" conaffinity="0" group="1" />
        <geom name="front_left_servo_hip_pitch" type="mesh" mesh="mesh_6" pos="0.012600007 0.00155 0.000699998" quat="-0.5 -0.5 -0.5 0.5" rgba=".16 .18 .22 1" contype="0" conaffinity="0" group="1" />
        <body name="front_left_upper_link" pos="-0.017399993 0 -0.013000002">
          <joint name="front_left_hip_pitch" type="hinge" axis="0 -1 0" range="-1.2 1.2" damping=".025" armature=".00002" />
          <inertial mass=".073625" pos="0.02733864795 0 -0.0211921065" diaginertia=".0000298 .0000298 .00000767" />
          <geom name="front_left_hip_pitch_L" type="mesh" mesh="mesh_2" pos="0.088361918 -0.0436 -0.035145675" quat="1 0 0 0" rgba=".62 .66 .72 1" contype="0" conaffinity="0" group="1" />
          <geom name="front_left_hip_pitch_R" type="mesh" mesh="mesh_3" pos="0.088361918 -0.0436 -0.035145675" quat="1 0 0 0" rgba=".62 .66 .72 1" contype="0" conaffinity="0" group="1" />
          <body name="front_left_lower_link" pos="0.060752551 0 -0.04709357">
            <joint name="front_left_knee_pitch" type="hinge" axis="0 -1 0" range="-1.5 1.5" damping=".025" armature=".00002" />
            <inertial mass=".015625" pos="-.025 0 -.04" diaginertia=".0000102 .0000102 .00000163" />
            <geom name="front_left_servo_knee_pitch" type="mesh" mesh="mesh_6" pos="0 0.00155 -0.0113" quat="0.5 0.5 -0.5 0.5" rgba=".16 .18 .22 1" contype="0" conaffinity="0" group="1" />
            <geom name="front_left_knee_v2" type="mesh" mesh="mesh_4" pos="0.029409367 -0.0436 0.046647895" quat="1 0 0 0" rgba=".62 .66 .72 1" contype="0" conaffinity="0" group="1" />
            <geom name="front_left_boot" type="mesh" mesh="mesh_5" pos="0.029409367 -0.0436 0.046647895" quat="1 0 0 0" rgba=".62 .66 .72 1" contype="0" conaffinity="0" group="1" />
            <body name="front_left_boot_mass" pos="-.0131 0 -.0656">
              <inertial mass=".005" pos="0 0 0" diaginertia=".000001 .000001 .000001" />
            </body>
            <geom name="front_left_foot_contact_proxy" type="sphere" pos="-.045 0 -.07" size=".003" rgba="0 0 0 0" group="3" contype="2" conaffinity="1" friction="1.0 .01 .001" solref=".02 1" solimp=".9 .95 .001" />
            <site name="front_left_foot" pos="-.045 0 -.07" size=".003" />
          </body>
        </body>
      </body>
      <geom name="front_left_servo_hip_roll" type="mesh" mesh="mesh_6" pos="-0.059876997 -0.0775 0.0277" quat="0 -0.7071067812 0 0.7071067812" rgba=".16 .18 .22 1" contype="0" conaffinity="0" group="1" />
      <body name="front_right_roll_link" pos="-0.108576997 0.0775 0.014">
        <joint name="front_right_hip_roll" type="hinge" axis="1 0 0" range="-.5 .5" damping=".025" armature=".00002" />
        <inertial mass=".066" pos="-0.017399993 0 -0.013000002" diaginertia=".0000176 .0000176 .0000176" />
        <geom name="front_right_hip_roll" type="mesh" mesh="mesh_1" pos="0.070961925 -0.0436 -0.048145677" quat="1 0 0 0" rgba=".62 .66 .72 1" contype="0" conaffinity="0" group="1" />
        <geom name="front_right_servo_hip_pitch" type="mesh" mesh="mesh_6" pos="0.012600007 0.00155 0.000699998" quat="-0.5 -0.5 -0.5 0.5" rgba=".16 .18 .22 1" contype="0" conaffinity="0" group="1" />
        <body name="front_right_upper_link" pos="-0.017399993 0 -0.013000002">
          <joint name="front_right_hip_pitch" type="hinge" axis="0 -1 0" range="-1.2 1.2" damping=".025" armature=".00002" />
          <inertial mass=".073625" pos="0.02733864795 0 -0.0211921065" diaginertia=".0000298 .0000298 .00000767" />
          <geom name="front_right_hip_pitch_L" type="mesh" mesh="mesh_2" pos="0.088361918 -0.0436 -0.035145675" quat="1 0 0 0" rgba=".62 .66 .72 1" contype="0" conaffinity="0" group="1" />
          <geom name="front_right_hip_pitch_R" type="mesh" mesh="mesh_3" pos="0.088361918 -0.0436 -0.035145675" quat="1 0 0 0" rgba=".62 .66 .72 1" contype="0" conaffinity="0" group="1" />
          <body name="front_right_lower_link" pos="0.060752551 0 -0.04709357">
            <joint name="front_right_knee_pitch" type="hinge" axis="0 -1 0" range="-1.5 1.5" damping=".025" armature=".00002" />
            <inertial mass=".015625" pos="-.025 0 -.04" diaginertia=".0000102 .0000102 .00000163" />
            <geom name="front_right_servo_knee_pitch" type="mesh" mesh="mesh_6" pos="0 0.00155 -0.0113" quat="0.5 0.5 -0.5 0.5" rgba=".16 .18 .22 1" contype="0" conaffinity="0" group="1" />
            <geom name="front_right_knee_v2" type="mesh" mesh="mesh_4" pos="0.029409367 -0.0436 0.046647895" quat="1 0 0 0" rgba=".62 .66 .72 1" contype="0" conaffinity="0" group="1" />
            <geom name="front_right_boot" type="mesh" mesh="mesh_5" pos="0.029409367 -0.0436 0.046647895" quat="1 0 0 0" rgba=".62 .66 .72 1" contype="0" conaffinity="0" group="1" />
            <body name="front_right_boot_mass" pos="-.0131 0 -.0656">
              <inertial mass=".005" pos="0 0 0" diaginertia=".000001 .000001 .000001" />
            </body>
            <geom name="front_right_foot_contact_proxy" type="sphere" pos="-.045 0 -.07" size=".003" rgba="0 0 0 0" group="3" contype="2" conaffinity="1" friction="1.0 .01 .001" solref=".02 1" solimp=".9 .95 .001" />
            <site name="front_right_foot" pos="-.045 0 -.07" size=".003" />
          </body>
        </body>
      </body>
      <geom name="front_right_servo_hip_roll" type="mesh" mesh="mesh_6" pos="-0.059876997 0.0775 0.0277" quat="0 -0.7071067812 0 0.7071067812" rgba=".16 .18 .22 1" contype="0" conaffinity="0" group="1" />
      <body name="rear_left_roll_link" pos="0.108576997 -0.0775 0.014">
        <joint name="rear_left_hip_roll" type="hinge" axis="1 0 0" range="-.5 .5" damping=".025" armature=".00002" />
        <inertial mass=".066" pos="0.017399993 0 -0.013000002" diaginertia=".0000176 .0000176 .0000176" />
        <geom name="rear_left_hip_roll" type="mesh" mesh="mesh_1" pos="-0.040961925 0.0436 -0.048145677" quat="0 0 0 1" rgba=".62 .66 .72 1" contype="0" conaffinity="0" group="1" />
        <geom name="rear_left_servo_hip_pitch" type="mesh" mesh="mesh_6" pos="0.017399993 0.00155 0.000699998" quat="-0.5 -0.5 -0.5 0.5" rgba=".16 .18 .22 1" contype="0" conaffinity="0" group="1" />
        <body name="rear_left_upper_link" pos="0.017399993 0 -0.013000002">
          <joint name="rear_left_hip_pitch" type="hinge" axis="0 -1 0" range="-1.2 1.2" damping=".025" armature=".00002" />
          <inertial mass=".073625" pos="0.01383864795 0 -0.0211921065" diaginertia=".0000298 .0000298 .00000767" />
          <geom name="rear_left_hip_pitch_L" type="mesh" mesh="mesh_2" pos="0.058361918 -0.0436 -0.035145675" quat="1 0 0 0" rgba=".62 .66 .72 1" contype="0" conaffinity="0" group="1" />
          <geom name="rear_left_hip_pitch_R" type="mesh" mesh="mesh_3" pos="0.058361918 -0.0436 -0.035145675" quat="1 0 0 0" rgba=".62 .66 .72 1" contype="0" conaffinity="0" group="1" />
          <body name="rear_left_lower_link" pos="0.030752551 0 -0.04709357">
            <joint name="rear_left_knee_pitch" type="hinge" axis="0 -1 0" range="-1.5 1.5" damping=".025" armature=".00002" />
            <inertial mass=".015625" pos="-.025 0 -.04" diaginertia=".0000102 .0000102 .00000163" />
            <geom name="rear_left_servo_knee_pitch" type="mesh" mesh="mesh_6" pos="0 0.00155 -0.0113" quat="0.5 0.5 -0.5 0.5" rgba=".16 .18 .22 1" contype="0" conaffinity="0" group="1" />
            <geom name="rear_left_knee_v2" type="mesh" mesh="mesh_4" pos="0.029409367 -0.0436 0.046647895" quat="1 0 0 0" rgba=".62 .66 .72 1" contype="0" conaffinity="0" group="1" />
            <geom name="rear_left_boot" type="mesh" mesh="mesh_5" pos="0.029409367 -0.0436 0.046647895" quat="1 0 0 0" rgba=".62 .66 .72 1" contype="0" conaffinity="0" group="1" />
            <body name="rear_left_boot_mass" pos="-.0131 0 -.0656">
              <inertial mass=".005" pos="0 0 0" diaginertia=".000001 .000001 .000001" />
            </body>
            <geom name="rear_left_foot_contact_proxy" type="sphere" pos="-.045 0 -.07" size=".003" rgba="0 0 0 0" group="3" contype="2" conaffinity="1" friction="1.0 .01 .001" solref=".02 1" solimp=".9 .95 .001" />
            <site name="rear_left_foot" pos="-.045 0 -.07" size=".003" />
          </body>
        </body>
      </body>
      <geom name="rear_left_servo_hip_roll" type="mesh" mesh="mesh_6" pos="0.089876997 -0.0775 0.0277" quat="0.7071067812 0 0.7071067812 0" rgba=".16 .18 .22 1" contype="0" conaffinity="0" group="1" />
      <body name="rear_right_roll_link" pos="0.108576997 0.0775 0.014">
        <joint name="rear_right_hip_roll" type="hinge" axis="1 0 0" range="-.5 .5" damping=".025" armature=".00002" />
        <inertial mass=".066" pos="0.017399993 0 -0.013000002" diaginertia=".0000176 .0000176 .0000176" />
        <geom name="rear_right_hip_roll" type="mesh" mesh="mesh_1" pos="-0.040961925 0.0436 -0.048145677" quat="0 0 0 1" rgba=".62 .66 .72 1" contype="0" conaffinity="0" group="1" />
        <geom name="rear_right_servo_hip_pitch" type="mesh" mesh="mesh_6" pos="0.017399993 0.00155 0.000699998" quat="-0.5 -0.5 -0.5 0.5" rgba=".16 .18 .22 1" contype="0" conaffinity="0" group="1" />
        <body name="rear_right_upper_link" pos="0.017399993 0 -0.013000002">
          <joint name="rear_right_hip_pitch" type="hinge" axis="0 -1 0" range="-1.2 1.2" damping=".025" armature=".00002" />
          <inertial mass=".073625" pos="0.01383864795 0 -0.0211921065" diaginertia=".0000298 .0000298 .00000767" />
          <geom name="rear_right_hip_pitch_L" type="mesh" mesh="mesh_2" pos="0.058361918 -0.0436 -0.035145675" quat="1 0 0 0" rgba=".62 .66 .72 1" contype="0" conaffinity="0" group="1" />
          <geom name="rear_right_hip_pitch_R" type="mesh" mesh="mesh_3" pos="0.058361918 -0.0436 -0.035145675" quat="1 0 0 0" rgba=".62 .66 .72 1" contype="0" conaffinity="0" group="1" />
          <body name="rear_right_lower_link" pos="0.030752551 0 -0.04709357">
            <joint name="rear_right_knee_pitch" type="hinge" axis="0 -1 0" range="-1.5 1.5" damping=".025" armature=".00002" />
            <inertial mass=".015625" pos="-.025 0 -.04" diaginertia=".0000102 .0000102 .00000163" />
            <geom name="rear_right_servo_knee_pitch" type="mesh" mesh="mesh_6" pos="0 0.00155 -0.0113" quat="0.5 0.5 -0.5 0.5" rgba=".16 .18 .22 1" contype="0" conaffinity="0" group="1" />
            <geom name="rear_right_knee_v2" type="mesh" mesh="mesh_4" pos="0.029409367 -0.0436 0.046647895" quat="1 0 0 0" rgba=".62 .66 .72 1" contype="0" conaffinity="0" group="1" />
            <geom name="rear_right_boot" type="mesh" mesh="mesh_5" pos="0.029409367 -0.0436 0.046647895" quat="1 0 0 0" rgba=".62 .66 .72 1" contype="0" conaffinity="0" group="1" />
            <body name="rear_right_boot_mass" pos="-.0131 0 -.0656">
              <inertial mass=".005" pos="0 0 0" diaginertia=".000001 .000001 .000001" />
            </body>
            <geom name="rear_right_foot_contact_proxy" type="sphere" pos="-.045 0 -.07" size=".003" rgba="0 0 0 0" group="3" contype="2" conaffinity="1" friction="1.0 .01 .001" solref=".02 1" solimp=".9 .95 .001" />
            <site name="rear_right_foot" pos="-.045 0 -.07" size=".003" />
          </body>
        </body>
      </body>
      <geom name="rear_right_servo_hip_roll" type="mesh" mesh="mesh_6" pos="0.089876997 0.0775 0.0277" quat="0.7071067812 0 0.7071067812 0" rgba=".16 .18 .22 1" contype="0" conaffinity="0" group="1" />
    </body>
  </worldbody>
  <actuator>
    <position name="front_left_hip_roll" joint="front_left_hip_roll" kp="12" kv=".15" forcerange="-1 1" forcelimited="true" />
    <position name="front_left_hip_pitch" joint="front_left_hip_pitch" kp="12" kv=".15" forcerange="-1 1" forcelimited="true" />
    <position name="front_left_knee_pitch" joint="front_left_knee_pitch" kp="12" kv=".15" forcerange="-1 1" forcelimited="true" />
    <position name="front_right_hip_roll" joint="front_right_hip_roll" kp="12" kv=".15" forcerange="-1 1" forcelimited="true" />
    <position name="front_right_hip_pitch" joint="front_right_hip_pitch" kp="12" kv=".15" forcerange="-1 1" forcelimited="true" />
    <position name="front_right_knee_pitch" joint="front_right_knee_pitch" kp="12" kv=".15" forcerange="-1 1" forcelimited="true" />
    <position name="rear_left_hip_roll" joint="rear_left_hip_roll" kp="12" kv=".15" forcerange="-1 1" forcelimited="true" />
    <position name="rear_left_hip_pitch" joint="rear_left_hip_pitch" kp="12" kv=".15" forcerange="-1 1" forcelimited="true" />
    <position name="rear_left_knee_pitch" joint="rear_left_knee_pitch" kp="12" kv=".15" forcerange="-1 1" forcelimited="true" />
    <position name="rear_right_hip_roll" joint="rear_right_hip_roll" kp="12" kv=".15" forcerange="-1 1" forcelimited="true" />
    <position name="rear_right_hip_pitch" joint="rear_right_hip_pitch" kp="12" kv=".15" forcerange="-1 1" forcelimited="true" />
    <position name="rear_right_knee_pitch" joint="rear_right_knee_pitch" kp="12" kv=".15" forcerange="-1 1" forcelimited="true" />
  </actuator>
</mujoco>
