masonk06/robot-dog-assembly/revision_one_oz/jlcpcb_pcba_revC_1oz/assembly/ASSEMBLY_BOTTOM.pdf

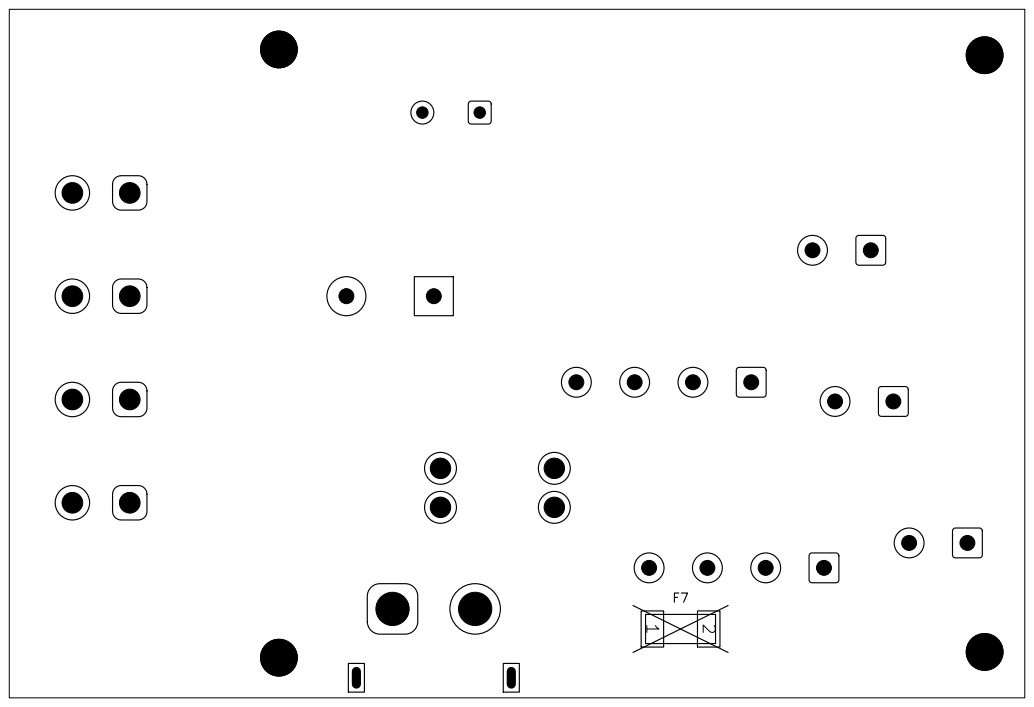
[picture p42: page 1]
