masonk06/robot-dog-assembly/revision_one_oz/COPPER-FINAL.pdf

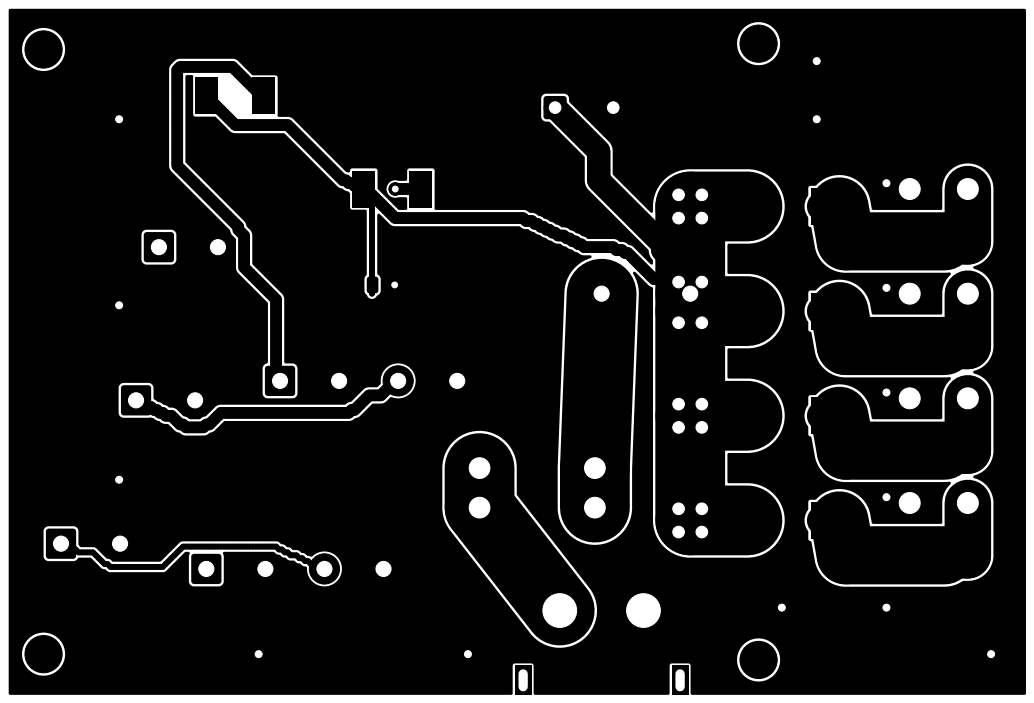
[picture p44: page 1]

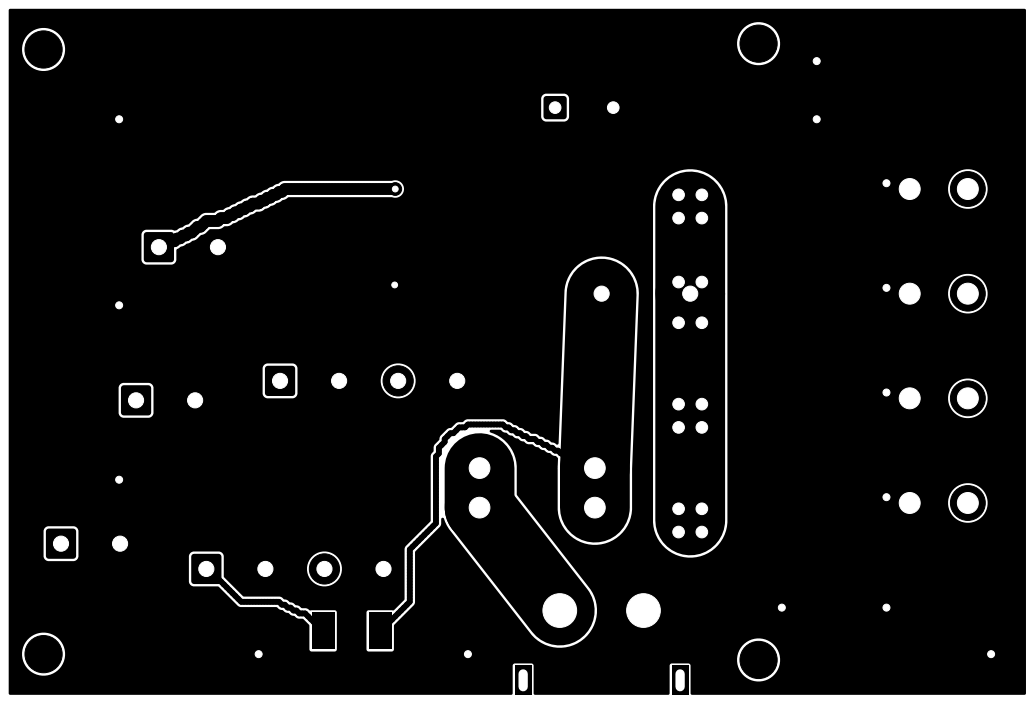
[picture p45: page 2]

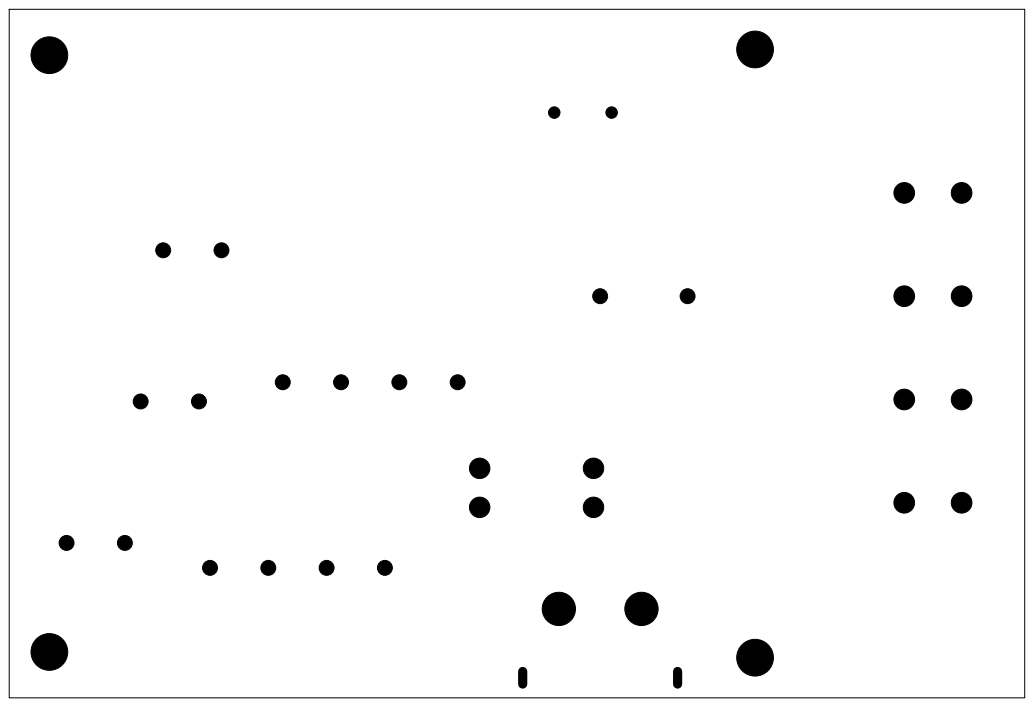
[picture p46: page 3]
