masonk06/robot-dog-assembly/revision_four_leg/jlcpcb_pcba_revB/assembly/ASSEMBLY_TOP.pdf

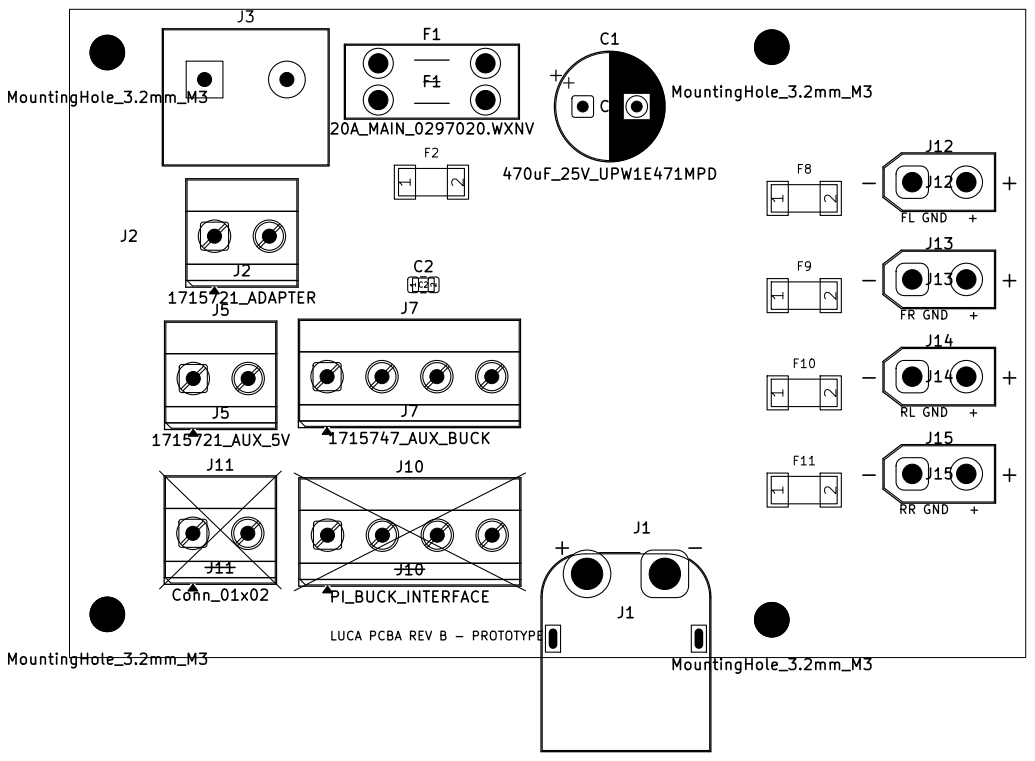
[picture p47: page 1]

LUCA PCBA REV B - PROTOTYPE
