masonk06/robot-dog-assembly/revision_one_oz/Luca_power_distribution_four_leg.kicad_pcb

## KiCad design revision_one_oz/Luca_power_distribution_four_leg.kicad_pcb (2026-11-05)

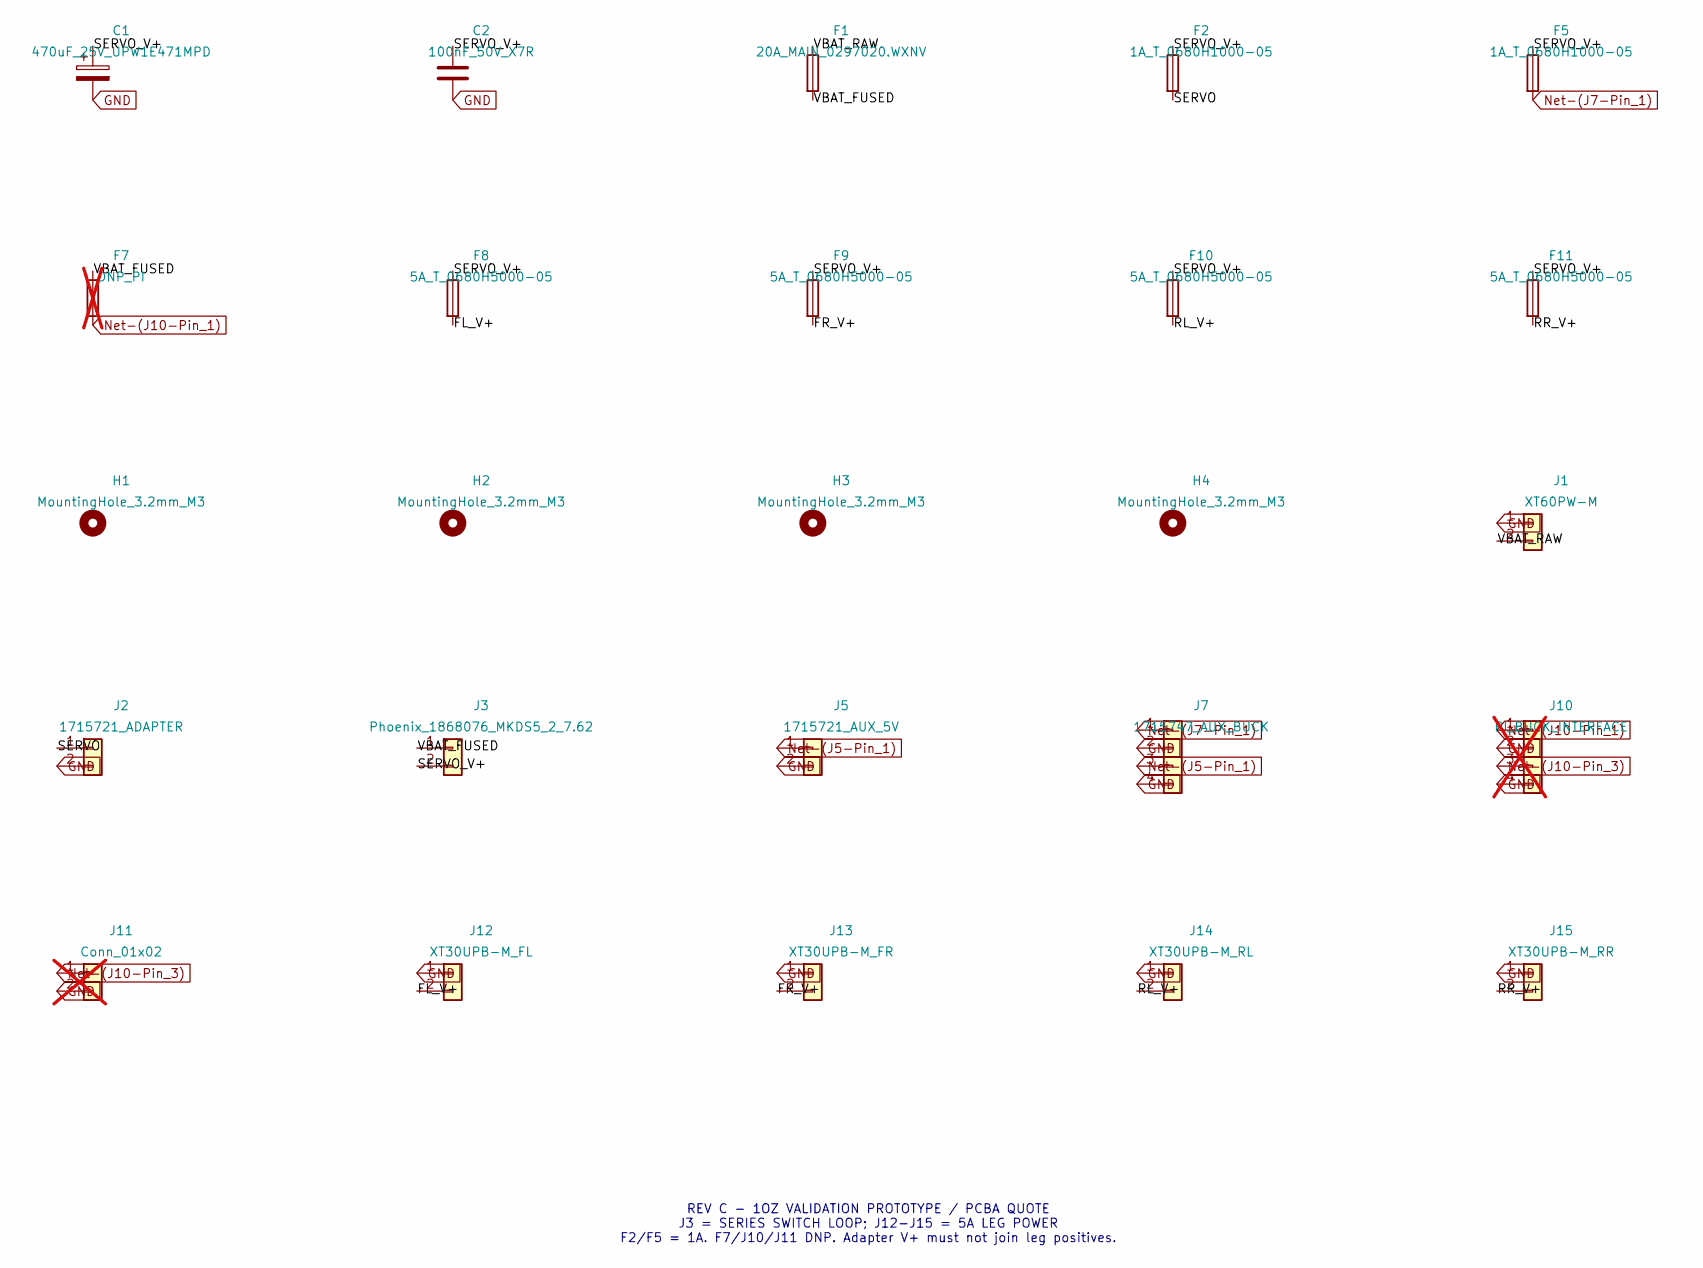
[picture p49: schematic Luca_power_distribution_four_leg.kicad_sch]

Parts:
C1: 470uF_25V_UPW1E471MPD; CP_Radial_D10.0mm_P5.00mm
C2: 100nF_50V_X7R; C_0805_2012Metric
F1: 20A_MAIN_0297020.WXNV; Fuseholder_Blade_Mini_Keystone_3568
F2, F5: 1A_T_0680H1000-05; Bel_0680H_2410_Recommended
F7: DNP_PI; Bel_0680H_2410_DNP_NoPaste; not fitted
F8, F9, F10, F11: 5A_T_0680H5000-05; Bel_0680H_2410_Recommended
H1, H2, H3, H4: MountingHole_3.2mm_M3
J1: XT60PW-M; AMASS_XT60PW_M_ReinforcedTabs
J2: 1715721_ADAPTER; TerminalBlock_Phoenix_MKDS-1,5-2-5.08_1x02_P5.08mm_Horizont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
J3: Phoenix_1868076_MKDS5_2_7.62; Phoenix_MKDS5_2_7.62_1868076
J5: 1715721_AUX_5V; TerminalBlock_Phoenix_MKDS-1,5-2-5.08_1x02_P5.08mm_Horizont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
J7: 1715747_AUX_BUCK; TerminalBlock_Phoenix_MKDS-1,5-4-5.08_1x04_P5.08mm_Horizont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
J10: PI_BUCK_INTERFACE; TerminalBlock_Phoenix_MKDS-1,5-4-5.08_1x04_P5.08mm_Horizont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; not fitted
J11: Conn_01x02; TerminalBlock_Phoenix_MKDS-1,5-2-5.08_1x02_P5.08mm_Horizont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; not fitted
J12: XT30UPB-M_FL; AMASS_XT30UPB-M_1x02_P5.0mm_Vertical
J13: XT30UPB-M_FR; AMASS_XT30UPB-M_1x02_P5.0mm_Vertical
J14: XT30UPB-M_RL; AMASS_XT30UPB-M_1x02_P5.0mm_Vertical
J15: XT30UPB-M_RR; AMASS_XT30UPB-M_1x02_P5.0mm_Vertical

Connections:
/FL_V+: F8.2, J12.2
/FR_V+: F9.2, J13.2
/RL_V+: F10.2, J14.2
/RR_V+: F11.2, J15.2
/SERVO: F2.2, J2.1
/SERVO_V+: C1.1, C2.1, F2.1, F5.1, F8.1, F9.1, F10.1, F11.1, J3.2
/VBAT_FUSED: F1.2, F7.1, J3.1
/VBAT_RAW: F1.1, J1.2
GND: C1.2, C2.2, J1.1, J2.2, J5.2, J7.2, J7.4, J10.2, J10.4, J11.2, J12.1, J13.1, J14.1, J15.1
unnamed: J5.1, J7.3
unnamed: F5.2, J7.1
unnamed: F7.2, J10.1
unnamed: J10.3, J11.1

Notes on the sheet:
REV C - 1OZ VALIDATION PROTOTYPE / PCBA QUOTE J3 = SERIES SWITCH LOOP; J12-J15 = 5A LEG POWER F2/F5 = 1A. F7/J10/J11 DNP. Adapter V+ must not join leg positives.

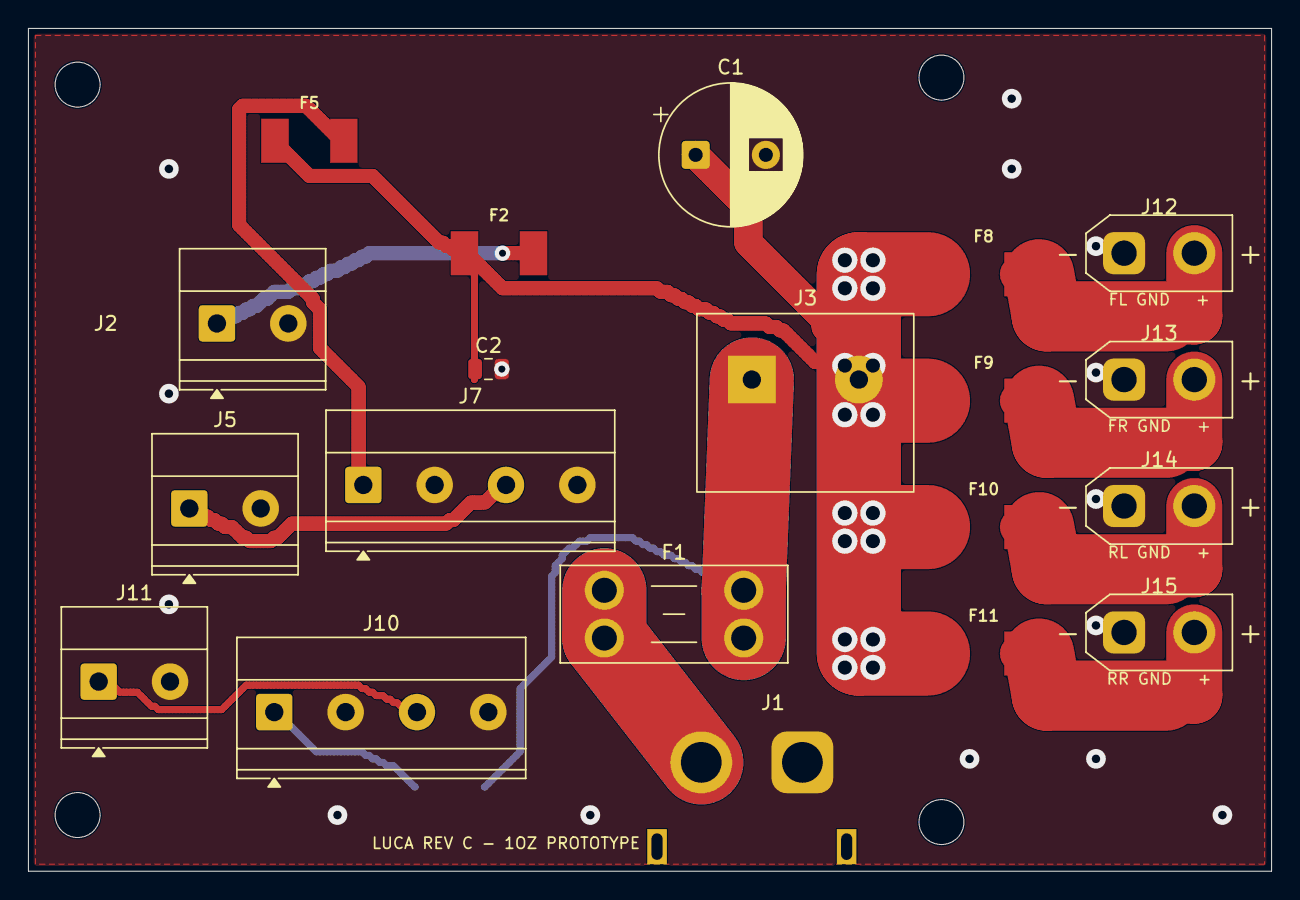
[picture p50: board Luca_power_distribution_four_leg.kicad_pcb from above]

Board: 2 copper layers, 88.5 x 60.0 mm, 25 parts (1 on the bottom side), 13 nets.
