masonk06/robot-dog-assembly/(commit log)

2026-10-24 Initial RoboDog assembly and calibration
2026-10-26 Organize RoboDog CAD, hardware, simulation and project documentation
2026-10-27 Preserve CUDA walking policies and rear-left calibration; clean project artifacts
2026-10-28 Add ESP32 calibration and read-only live mirror
2026-10-31 Improve Luca engineering overview and add ground-contact diagnostic GIF
    Reorganize the overview, stack, calibration workflow, evidence, and next milestones. Add a 10-second original-speed excerpt of the October 30 diagnostic with explicit validation limits.
2026-11-04 Add final frame and electronics design workspace
2026-11-04 Save four-leg PCB routing, J3 upgrade, and harness review files
2026-11-05 Record walking loads, servo harness details, and independent Pi supply
2026-11-05 Retain 5A leg chains and widen shared power copper with review audit
2026-11-05 Prepare revision B prototype PCBA package with BOM and placement drawings
2026-11-05 Add revision C for 1oz copper and all-top component assembly
